rice-eclipse/arca/ARCA/ARCA Block Diagram.pdf

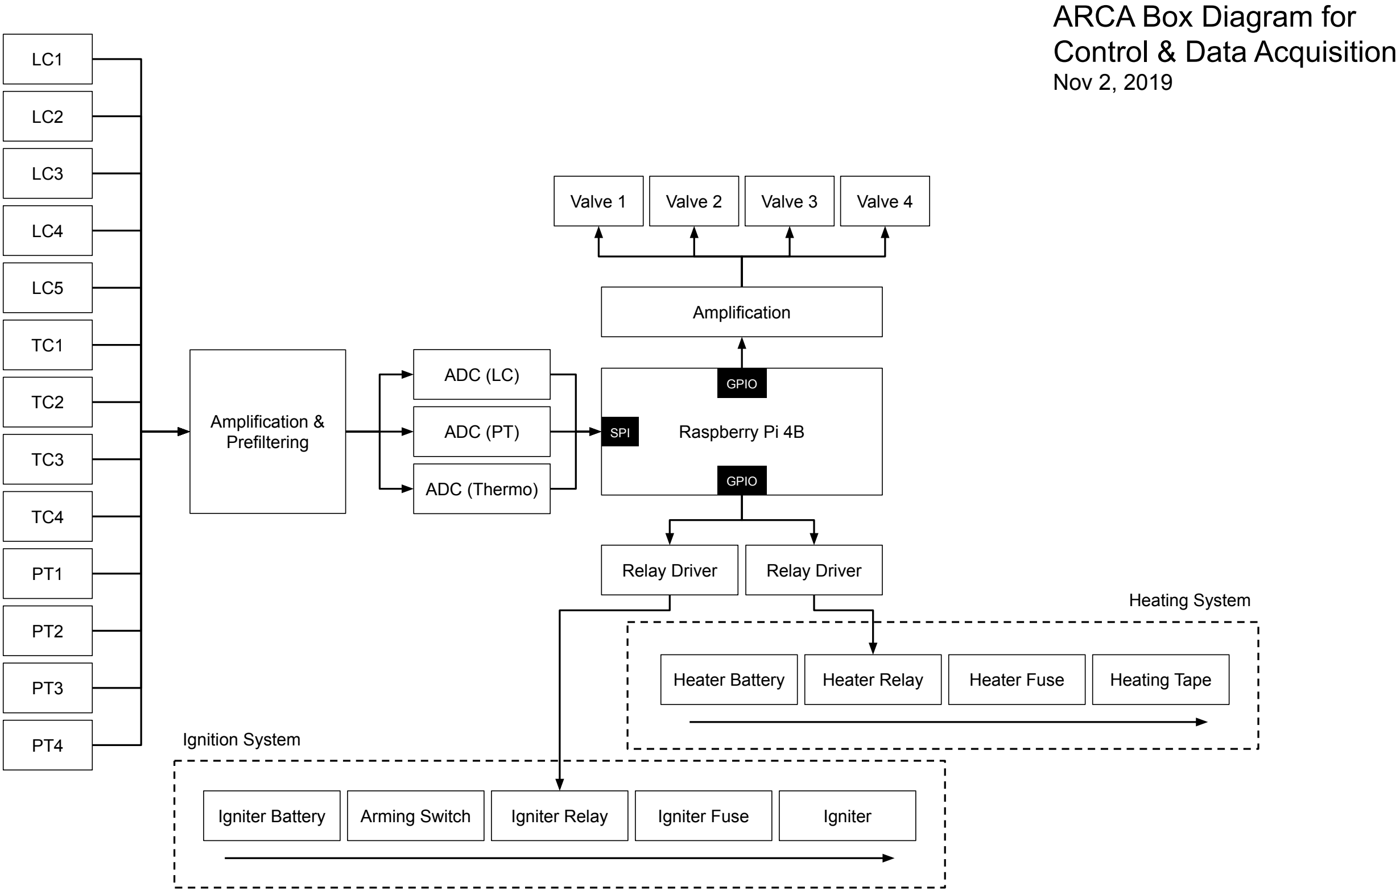
[picture p1: figure]
Raspberry Pi 4B; Amplification; Valve 1; Valve 2; Valve 3; Valve 4; ADC (LC); ADC (PT); ADC (Thermo); Amplification & Prefiltering; Relay Driver; Igniter Battery; Arming Switch; Igniter Relay; Igniter Fuse; Igniter; Heater Battery; Heater Relay; Heater Fuse; Heating Tape; Ignition System; Heating System; SPI; GPIO; ARCA Box Diagram for Control & Data Acquisition; Nov 2, 2019
