rice-eclipse/arca/ARCA/nass_magnet_overview_108_030_0264.PNG

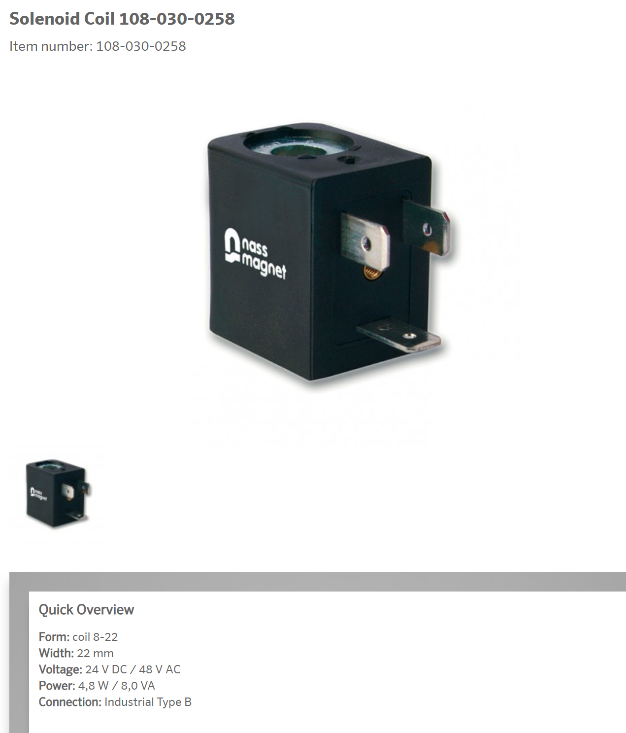
ARCA/nass_magnet_overview_108_030_0264.PNG
