rice-eclipse/arca/arca-2.0/3D CAD/CONNECTOR ANGLED 5MM PITCH (PHOENIX LPTA 2.5-X-5.0)/CONNECTOR ANGLED 5MM PITCH (PHOENIX LPTA 2.5-X-5.0).SLDASM

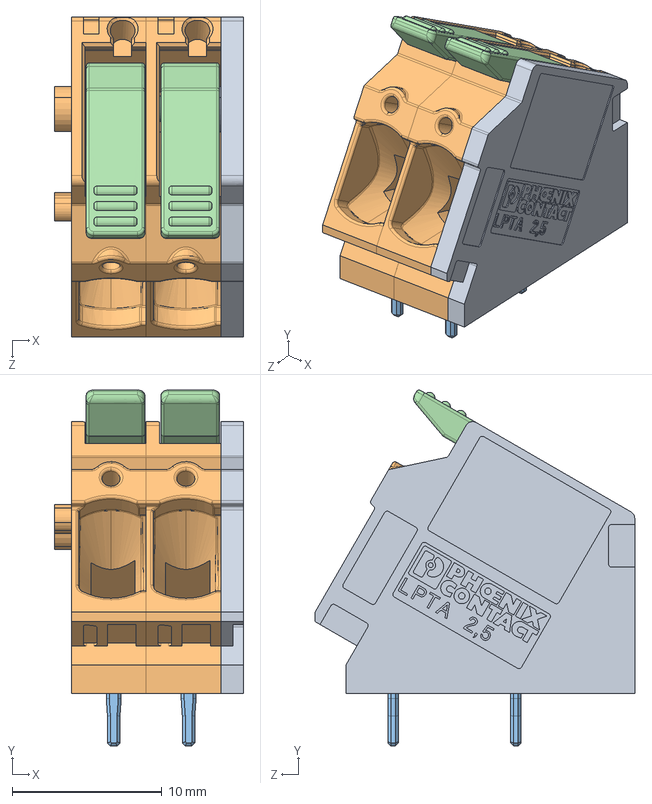
[picture p3: CAD file, 2022-02-19]
arca-2.0/3D CAD/CONNECTOR ANGLED 5MM PITCH (PHOENIX LPTA 2.5-X-5.0)/CONNECTOR ANGLED 5MM PITCH (PHOENIX LPTA 2.5-X-5.0).SLDASM
12.6 x 23.8 x 21.4 mm
DK_LPTA_2_5_5_00
PK_LPTA_2_5_5_00 x 2
LP_LPT_2_5_3_50 x 4
AC_LPT_2_5_LEVER x 2
