rice-eclipse/arca/arca-2.0/3D CAD/EXPORT/BOARD ARCA2.0 EAGLE EXPORT.SLDASM

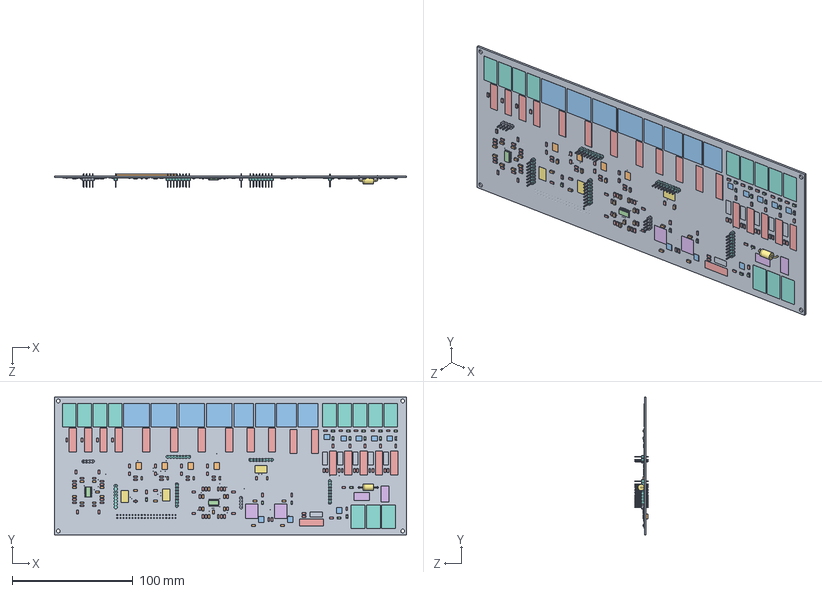
[picture p4: CAD file, 2022-02-19]
arca-2.0/3D CAD/EXPORT/BOARD ARCA2.0 EAGLE EXPORT.SLDASM
292.1 x 114.3 x 11.3 mm
Board^BOARD ARCA2.0 EAGLE EXPORT
0.1u^BOARD ARCA2.0 EAGLE EXPORT x 29
SS54^BOARD ARCA2.0 EAGLE EXPORT x 8
CHIPLED_1206^BOARD ARCA2.0 EAGLE EXPORT x 16
68^BOARD ARCA2.0 EAGLE EXPORT x 85
LM1084-ADJ^BOARD ARCA2.0 EAGLE EXPORT x 2
DO201-15^BOARD ARCA2.0 EAGLE EXPORT
LPTA-2POS^BOARD ARCA2.0 EAGLE EXPORT x 12
FQP30N06L^BOARD ARCA2.0 EAGLE EXPORT x 6
MCP6N11R^BOARD ARCA2.0 EAGLE EXPORT x 4
LPTA-4POS^BOARD ARCA2.0 EAGLE EXPORT x 4
LM324D^BOARD ARCA2.0 EAGLE EXPORT x 2
178.6165^BOARD ARCA2.0 EAGLE EXPORT x 18
1101M2S3CQE2^BOARD ARCA2.0 EAGLE EXPORT x 2
MCP3208SN^BOARD ARCA2.0 EAGLE EXPORT x 3
1X08^BOARD ARCA2.0 EAGLE EXPORT x 5
1X04^BOARD ARCA2.0 EAGLE EXPORT x 2
2540-5^BOARD ARCA2.0 EAGLE EXPORT
LPTA-3POS^BOARD ARCA2.0 EAGLE EXPORT x 4
