rice-eclipse/arca/arca-2.0/3D CAD/BOARD INSERT ASSEMBLY.SLDASM

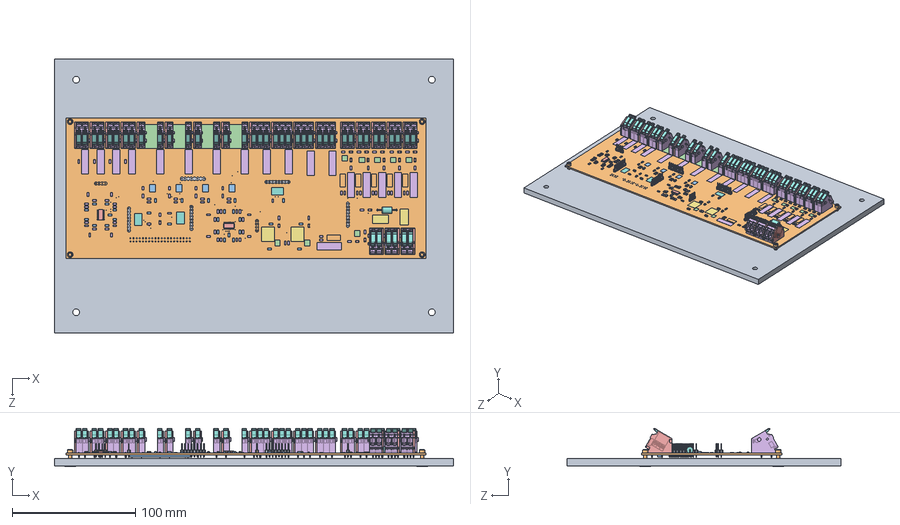
[picture p5: CAD file, 2022-02-19]
arca-2.0/3D CAD/BOARD INSERT ASSEMBLY.SLDASM
323.9 x 31.2 x 222.2 mm
BASE BOARD
Board^BOARD ARCA2.0 EAGLE EXPORT
0.1u^BOARD ARCA2.0 EAGLE EXPORT x 29
SS54^BOARD ARCA2.0 EAGLE EXPORT x 8
CHIPLED_1206^BOARD ARCA2.0 EAGLE EXPORT x 16
68^BOARD ARCA2.0 EAGLE EXPORT x 85
LM1084-ADJ^BOARD ARCA2.0 EAGLE EXPORT x 2
DO201-15^BOARD ARCA2.0 EAGLE EXPORT
LPTA-2POS^BOARD ARCA2.0 EAGLE EXPORT x 12
FQP30N06L^BOARD ARCA2.0 EAGLE EXPORT x 6
MCP6N11R^BOARD ARCA2.0 EAGLE EXPORT x 4
LPTA-4POS^BOARD ARCA2.0 EAGLE EXPORT x 4
LM324D^BOARD ARCA2.0 EAGLE EXPORT x 2
178.6165^BOARD ARCA2.0 EAGLE EXPORT x 18
1101M2S3CQE2^BOARD ARCA2.0 EAGLE EXPORT x 2
MCP3208SN^BOARD ARCA2.0 EAGLE EXPORT x 3
1X08^BOARD ARCA2.0 EAGLE EXPORT x 5
1X04^BOARD ARCA2.0 EAGLE EXPORT x 2
2540-5^BOARD ARCA2.0 EAGLE EXPORT
LPTA-3POS^BOARD ARCA2.0 EAGLE EXPORT x 4
DK_LPTA_2_5_5_00 x 20
PK_LPTA_2_5_5_00 x 44
LP_LPT_2_5_3_50 x 88
AC_LPT_2_5_LEVER x 44
TEE NUT #4-40 (MCMASTER 90975A002) x 4
SHCS STL #4-40 (MCMASTER) x 4
