rice-eclipse/arca/arca-2.0/3D CAD/CONNECTOR ANGLED 5MM PITCH (PHOENIX LPTA 2.5-X-5.0)/AC_LPT_2_5_LEVER.SLDPRT

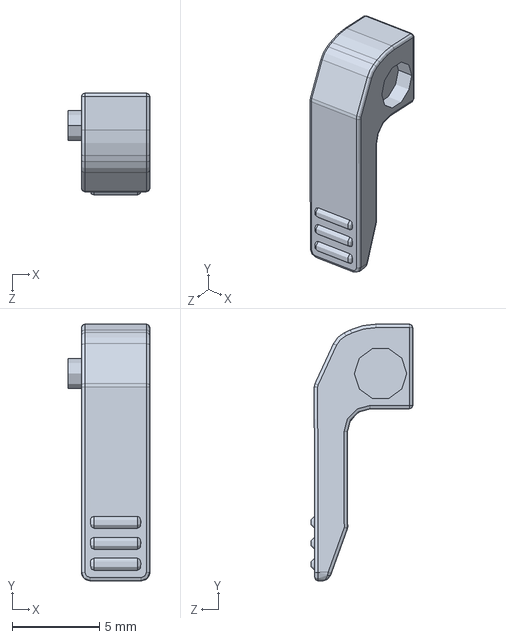
[picture p7: CAD file, 2022-02-19]
arca-2.0/3D CAD/CONNECTOR ANGLED 5MM PITCH (PHOENIX LPTA 2.5-X-5.0)/AC_LPT_2_5_LEVER.SLDPRT
4.68 x 14.7 x 5.83 mm
