rice-eclipse/arca/arca-2.0/3D CAD/CONNECTOR ANGLED 5MM PITCH (PHOENIX LPTA 2.5-X-5.0)/PK_LPTA_2_5_5_00.SLDPRT

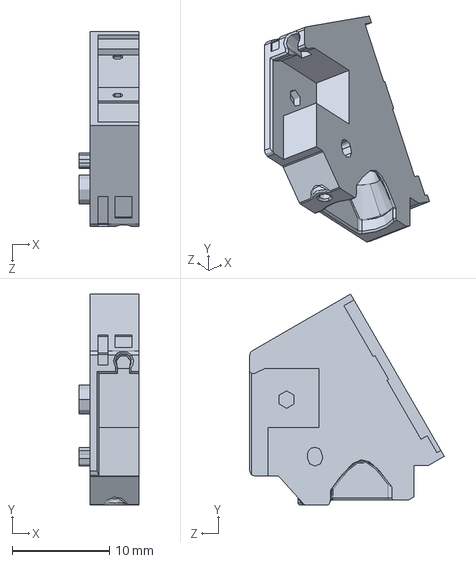
[picture p8: CAD file, 2022-02-19]
arca-2.0/3D CAD/CONNECTOR ANGLED 5MM PITCH (PHOENIX LPTA 2.5-X-5.0)/PK_LPTA_2_5_5_00.SLDPRT
6.13 x 21.7 x 20.0 mm
