rice-eclipse/arca/arca-2.0/3D CAD/BASE BOARD.SLDPRT

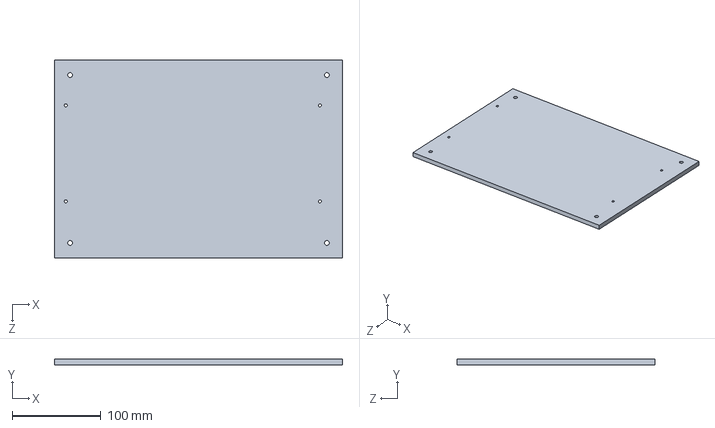
[picture p9: CAD file, 2022-02-19]
arca-2.0/3D CAD/BASE BOARD.SLDPRT
323.9 x 6.35 x 222.2 mm
