rice-eclipse/arca/arca-2.0/3D CAD/TEE NUT #4-40 (MCMASTER 90975A002).SLDPRT

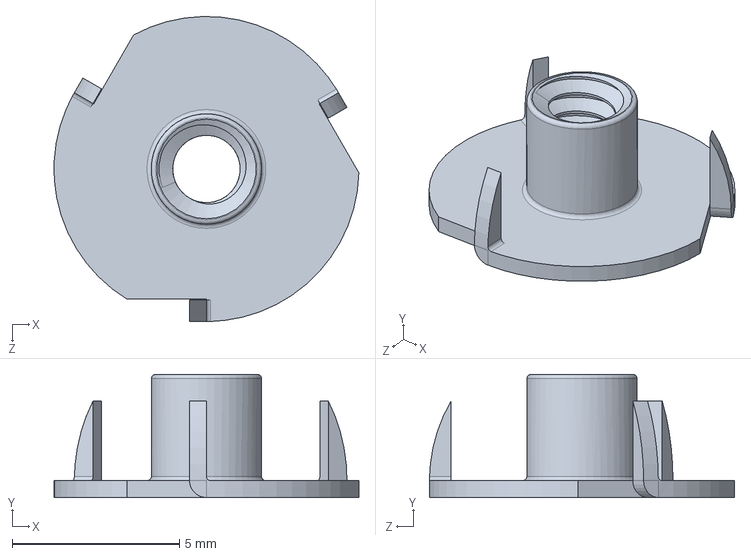
[picture p10: CAD file, 2022-02-19]
arca-2.0/3D CAD/TEE NUT #4-40 (MCMASTER 90975A002).SLDPRT
9.12 x 3.68 x 9.13 mm
