rice-eclipse/arca/arca-2.0/3D CAD/SHCS STL #4-40 (MCMASTER).SLDPRT

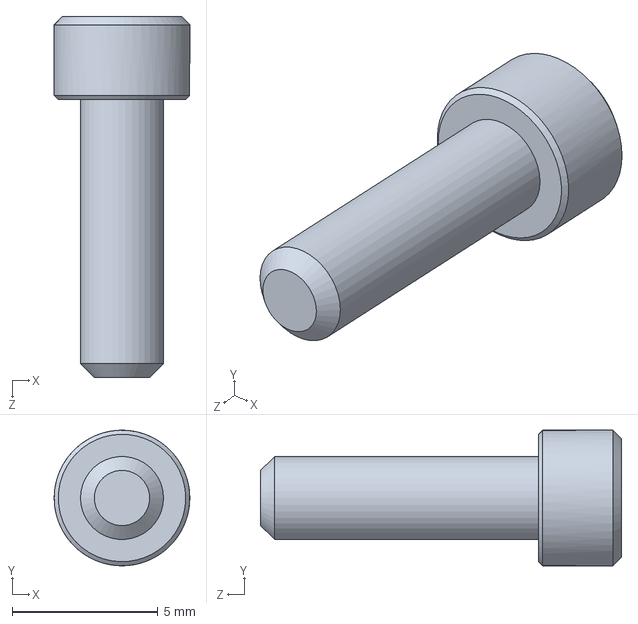
[picture p11: CAD file, 2022-02-19]
arca-2.0/3D CAD/SHCS STL #4-40 (MCMASTER).SLDPRT
4.65 x 4.65 x 12.4 mm
