rice-eclipse/arca/(list of files, cad)

Other CAD files:
eagle arca/arca.DWG
arca-2.0/3D CAD/CONNECTOR ANGLED 5MM PITCH (PHOENIX LPTA 2.5-X-5.0)/DK_LPTA_2_5_5_00.SLDPRT
arca-2.0/3D CAD/CONNECTOR ANGLED 5MM PITCH (PHOENIX LPTA 2.5-X-5.0)/LP_LPT_2_5_3_50.SLDPRT
