rice-eclipse/arca/ARCA/JLC Status/ARCA 1.1 Design Changes.txt

- Replace MCP6N11 inamp footprints to match real size
- Set pullup resistor values on SPI CS for ADCs to 2k
- Re-routed everything
- Rounded resistor values on Butterworth filters to closest E48 values
