rice-eclipse/arca/ARCA/Issues with board.docx

Fix these in a reprint run down the line.

- No silkscreen for SPI debug pins.
- LC circuit is wrong, need to use instrumentation amplifier for good performance.
- PT powered off of unregulated 12V supply. Need to use 10V or else we’re fucked.
- Burned out 5V LED, use bigger resistor next time.
- Should also take some time to make an ignition measurement device.
