rice-eclipse/arca/ARCA/arca.pdf

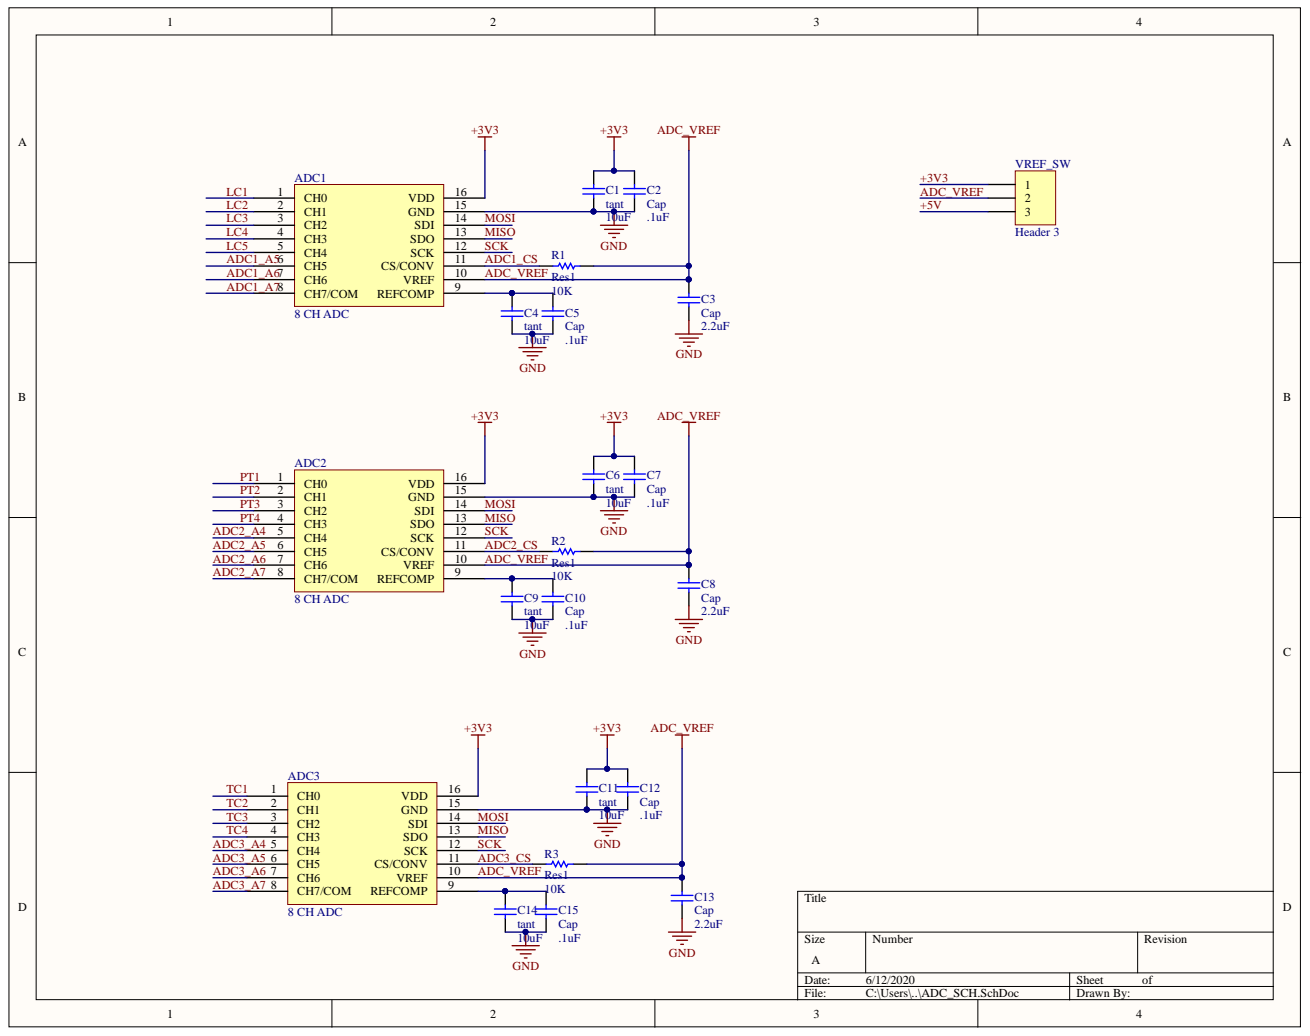
[picture p12: page 1]

A DC_VRE F

A DC_VRE F Re s 1

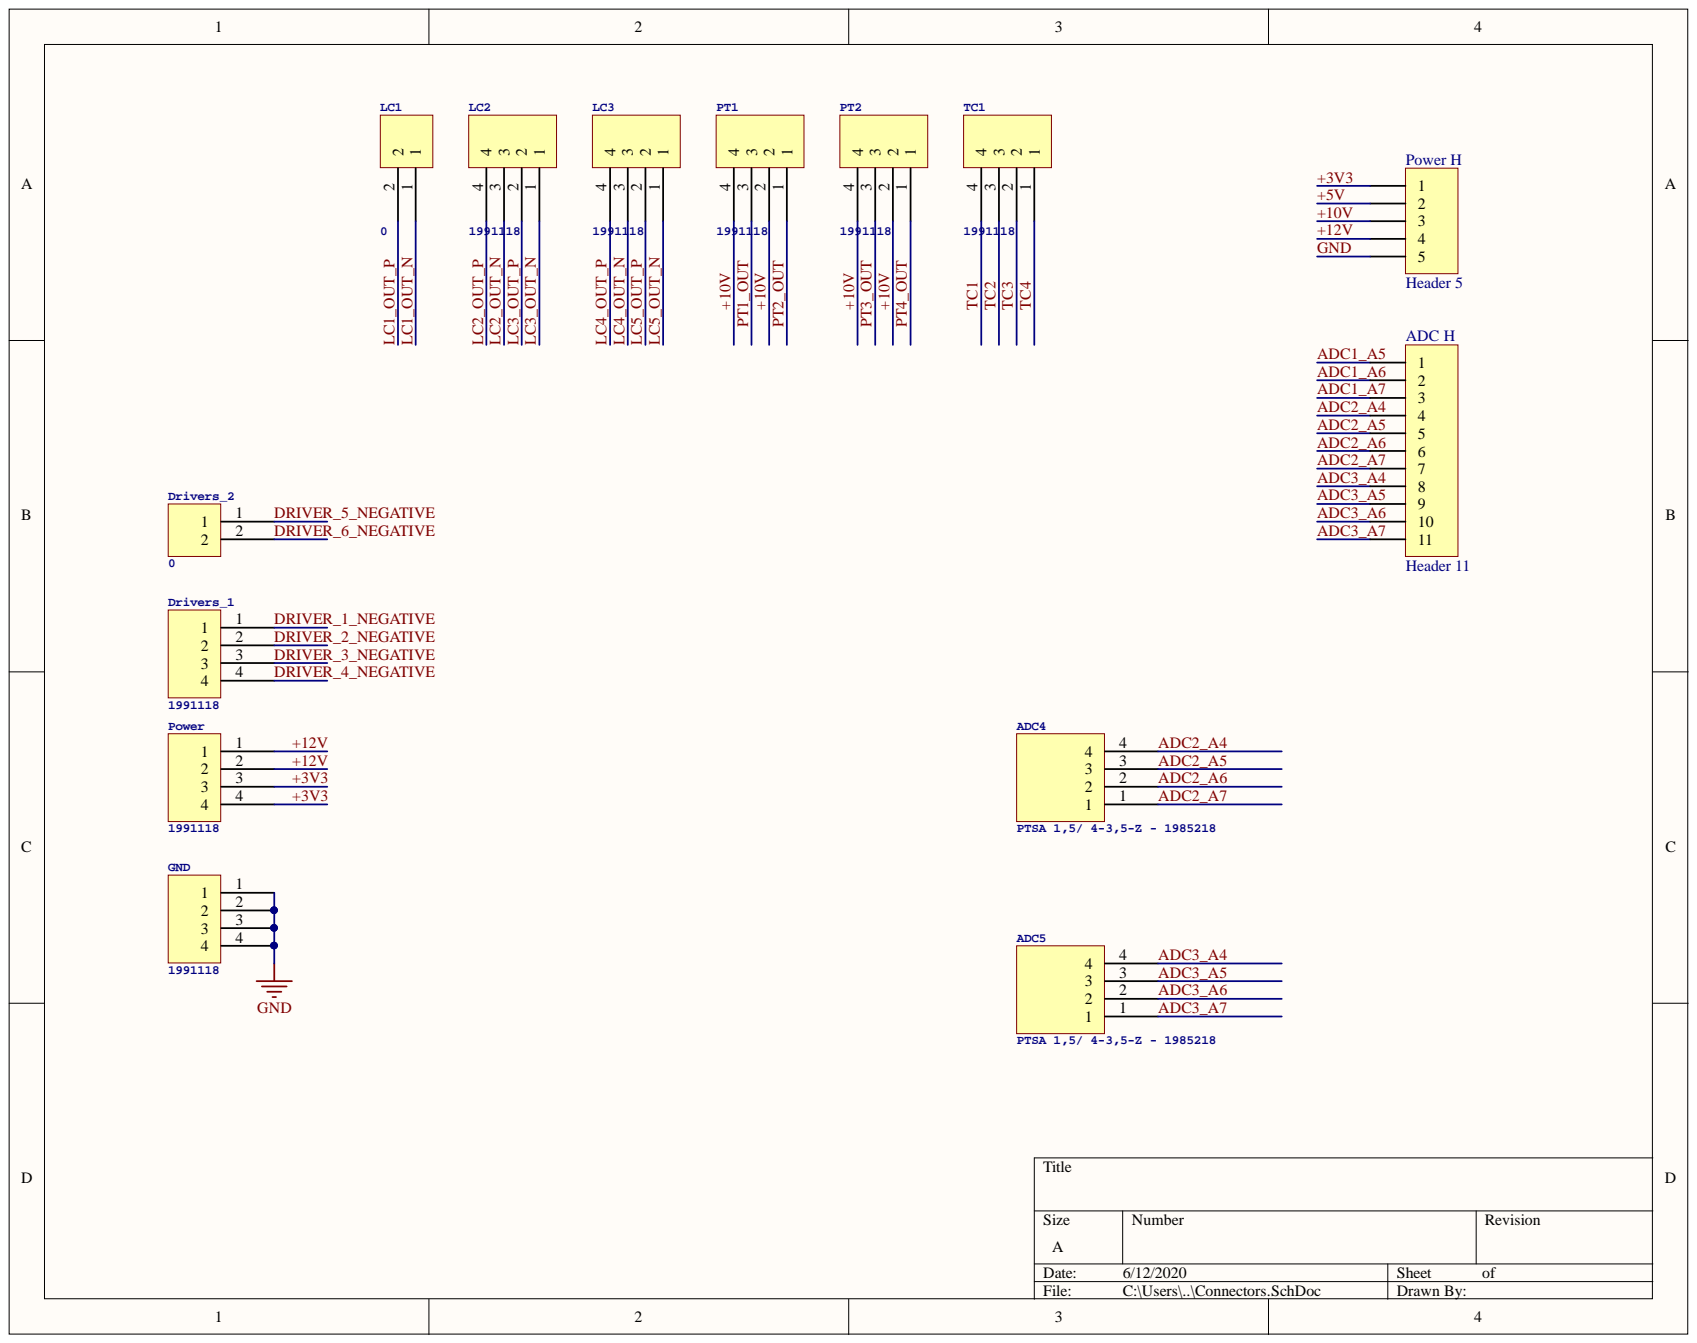
[picture p13: page 2]

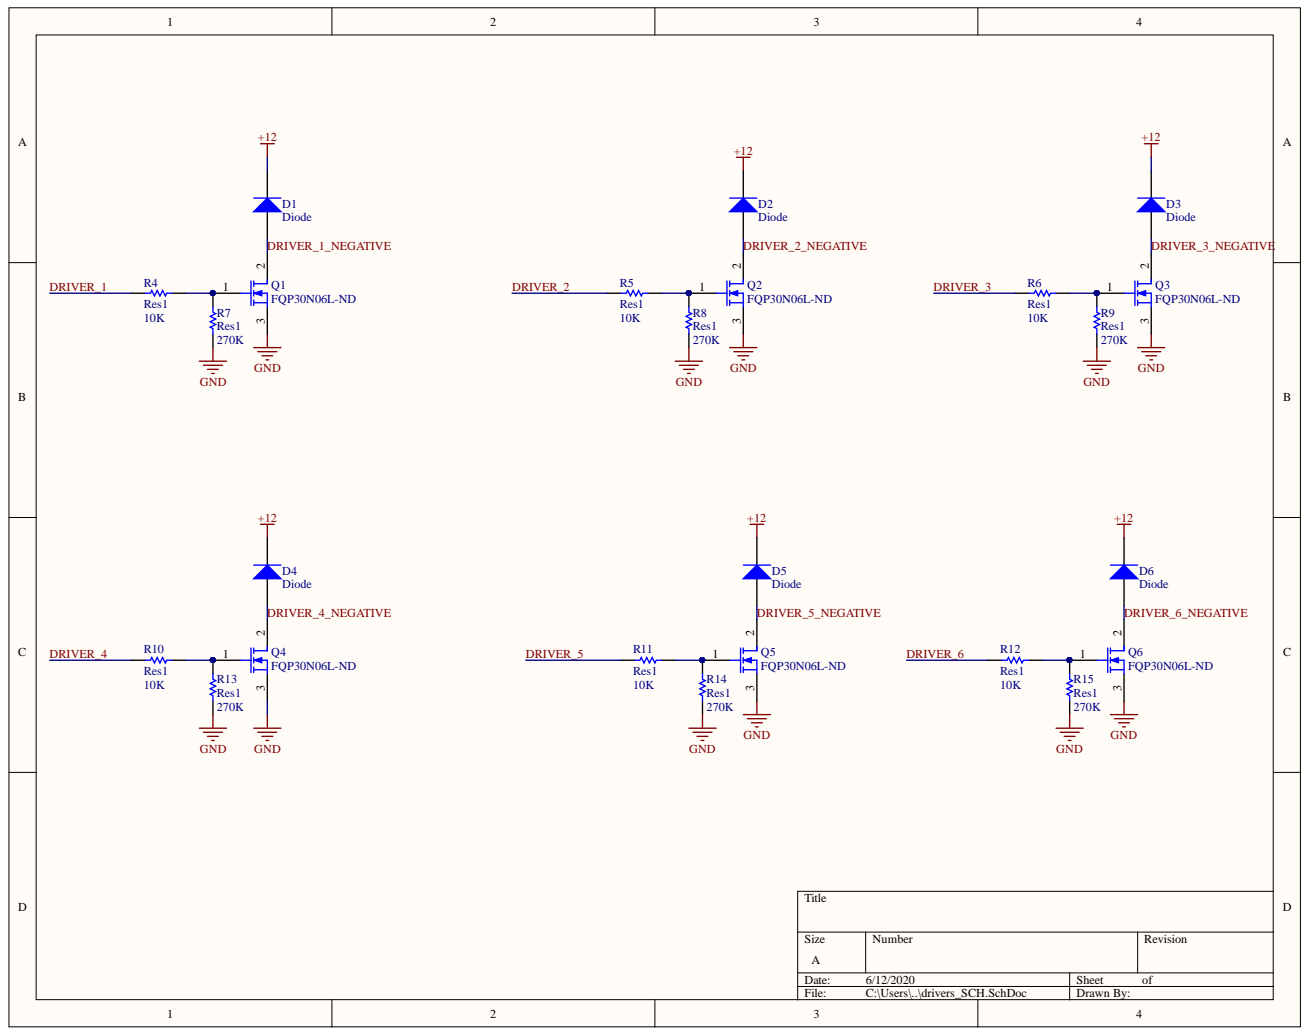
[picture p14: page 3]

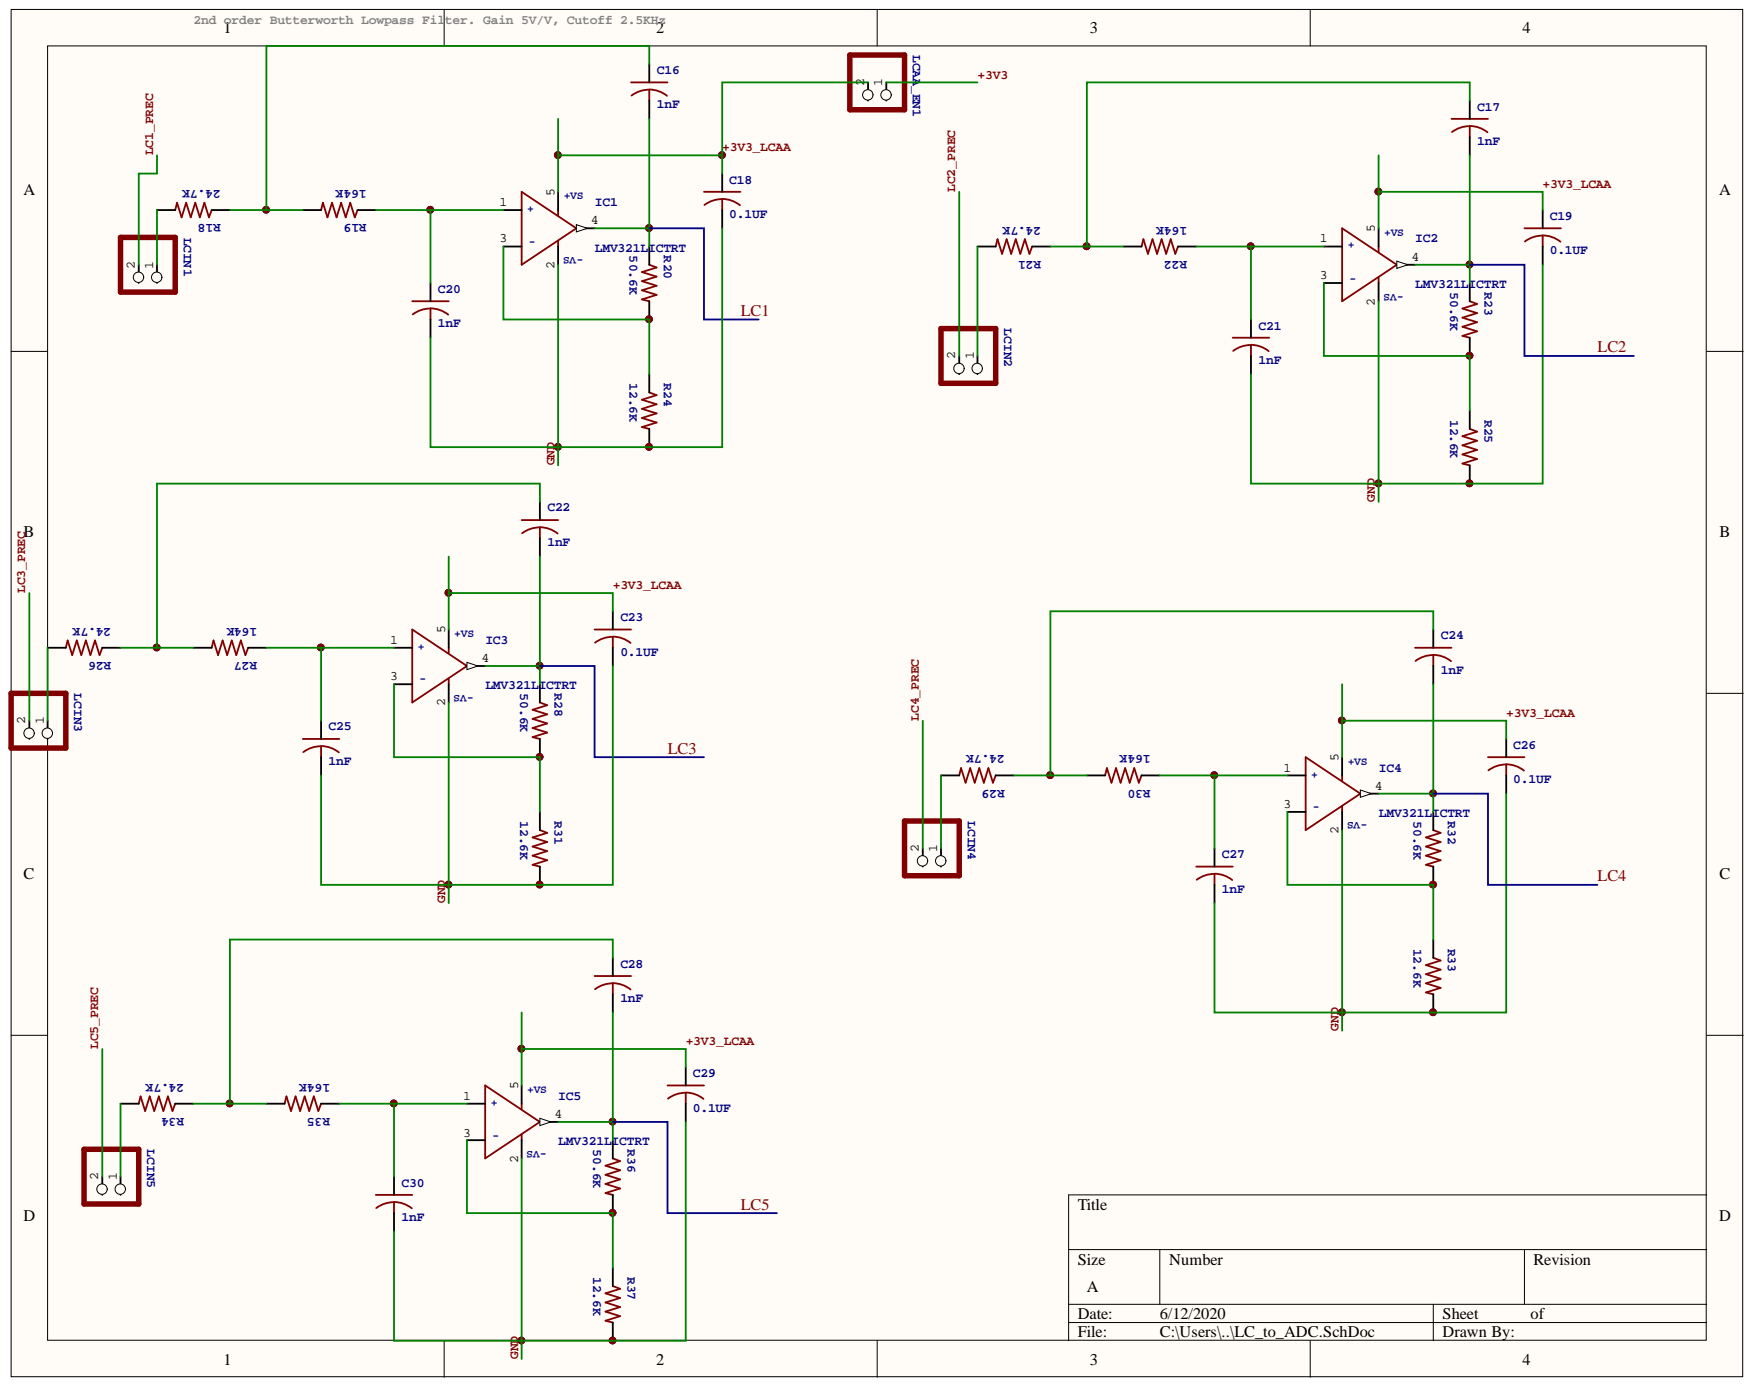
[picture p15: page 4]

2nd order Butterworth Lowpass Filter. Gain 5V/V, Cutoff 2.5KHz

LMV321LICTRT

+3V3_LCAA 5_PREC

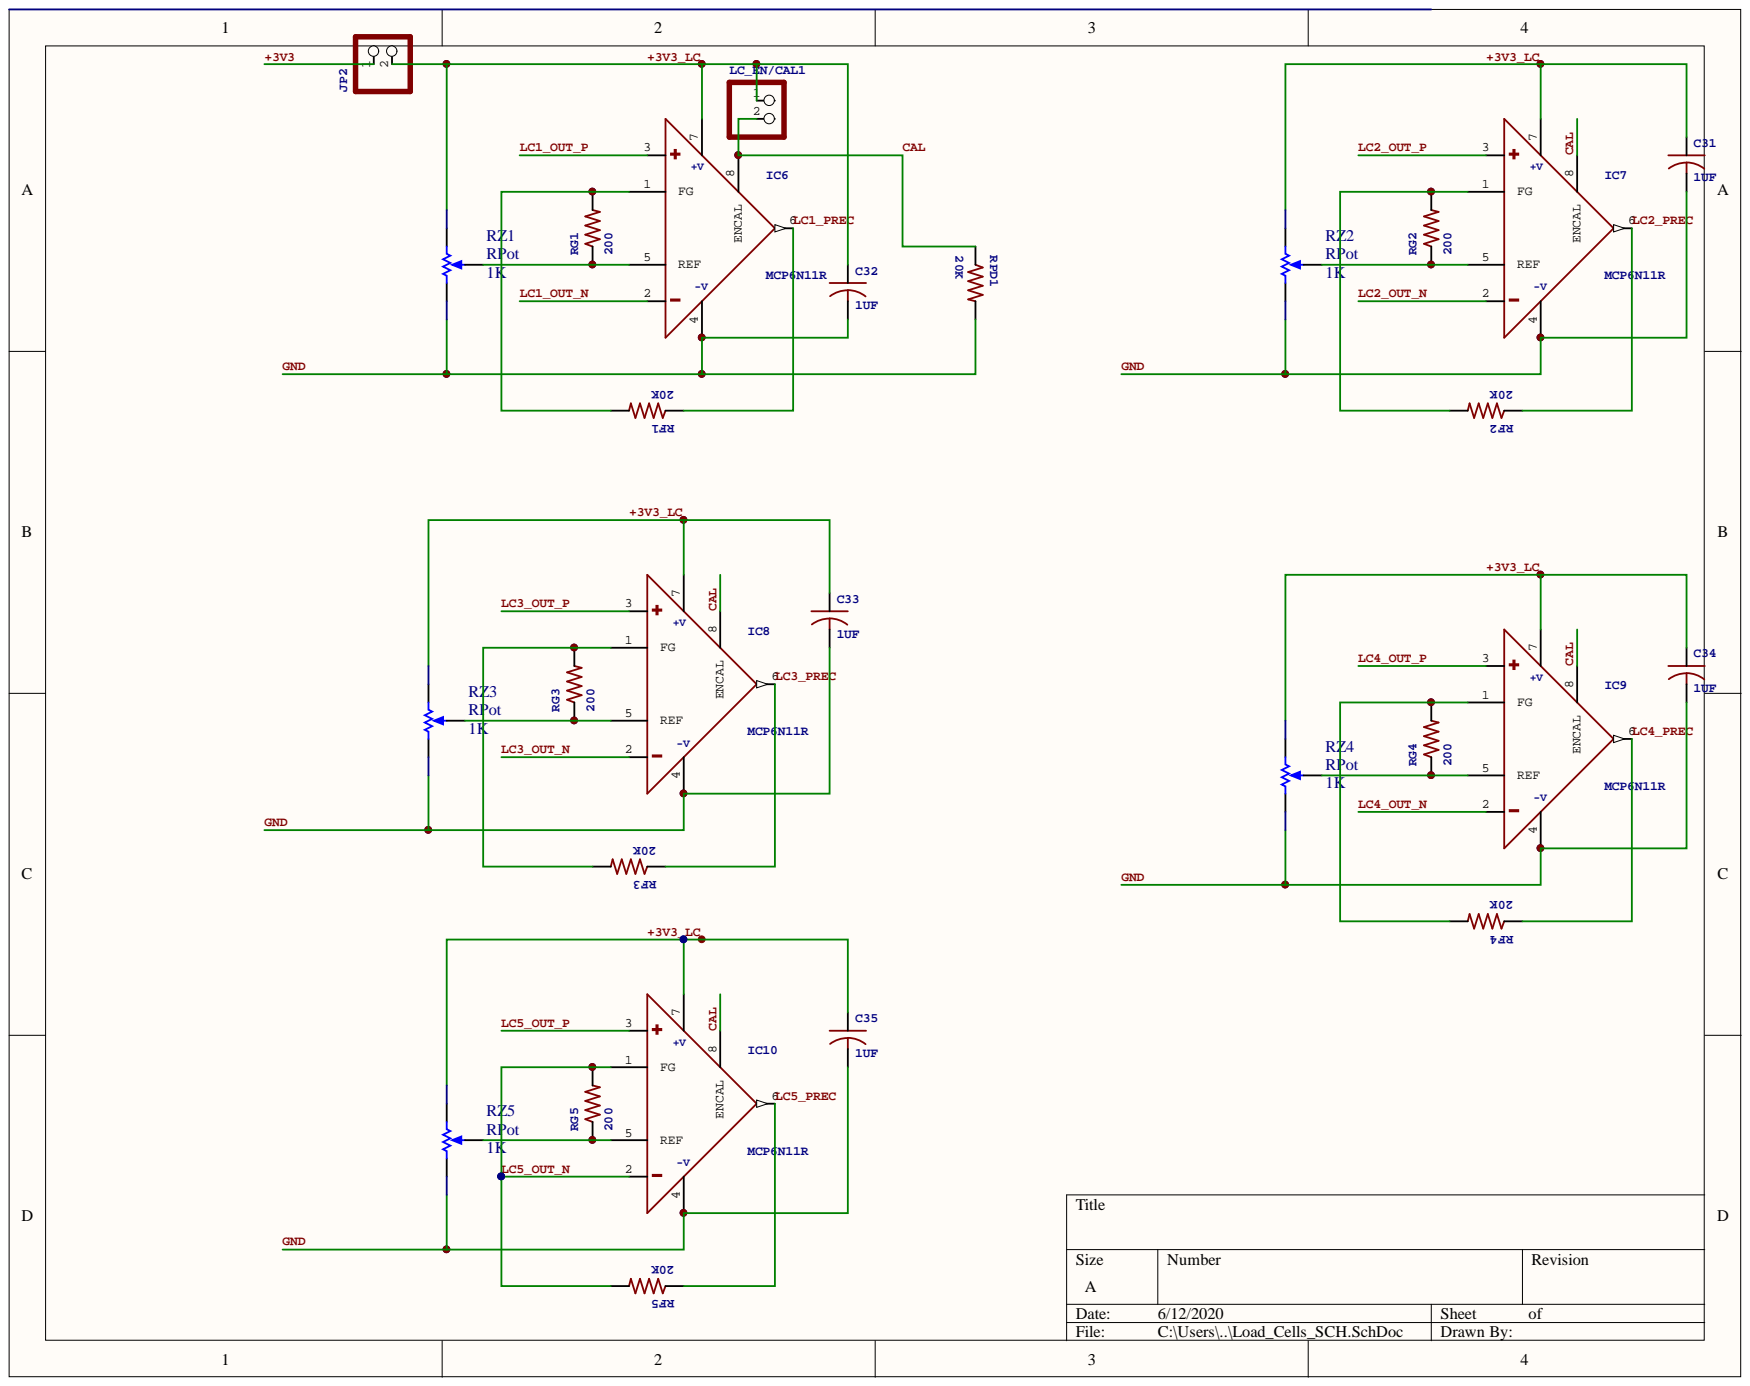
[picture p16: page 5]

LC_EN/CAL1

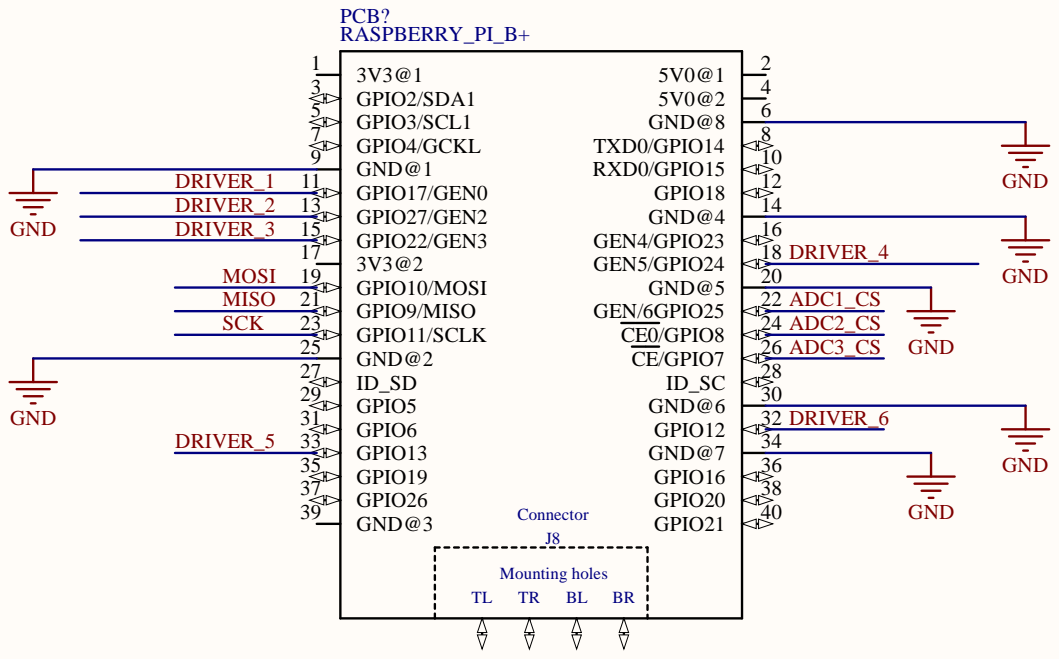
[picture p17: page 6]

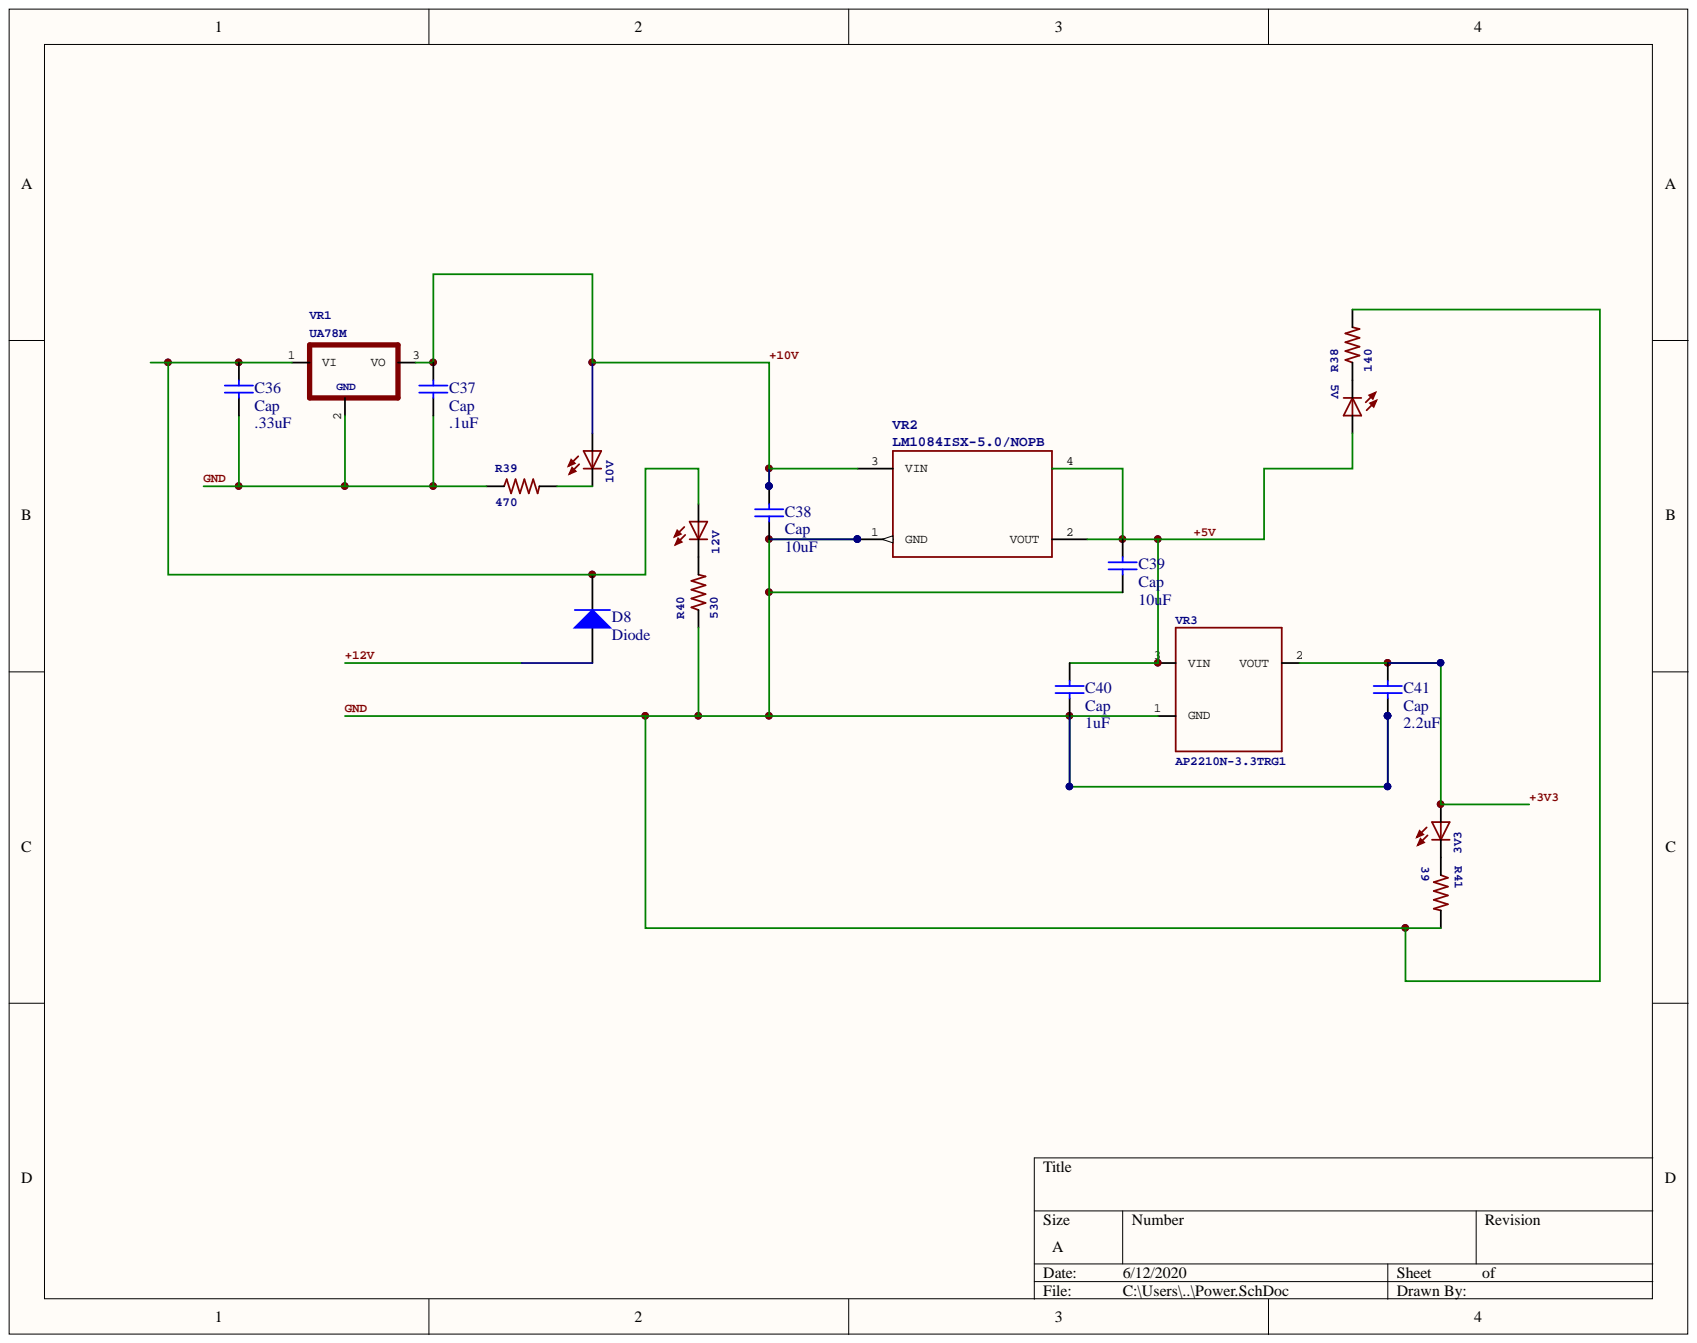
[picture p18: page 7]

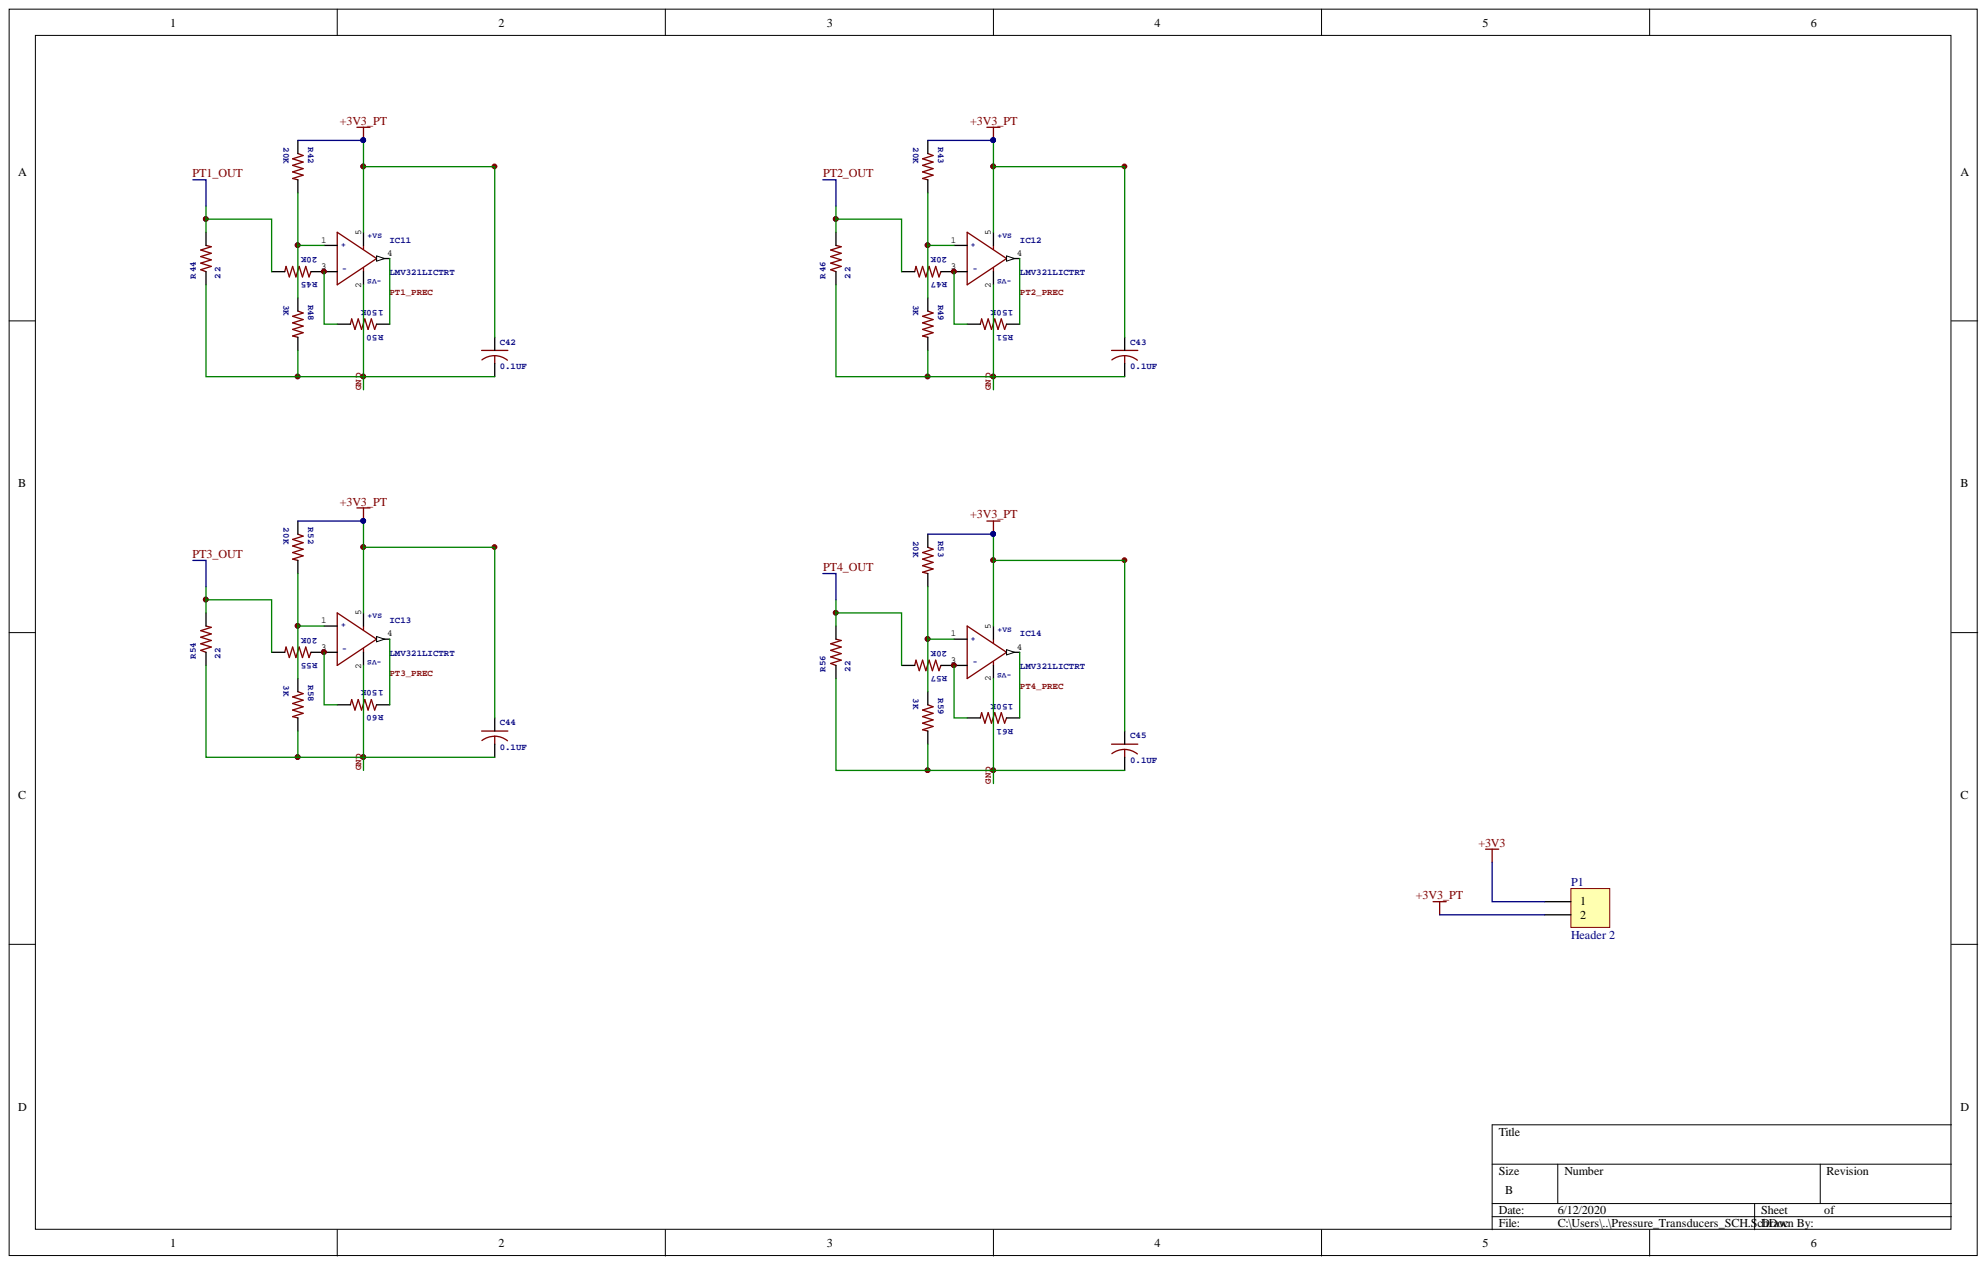
[picture p19: page 8]

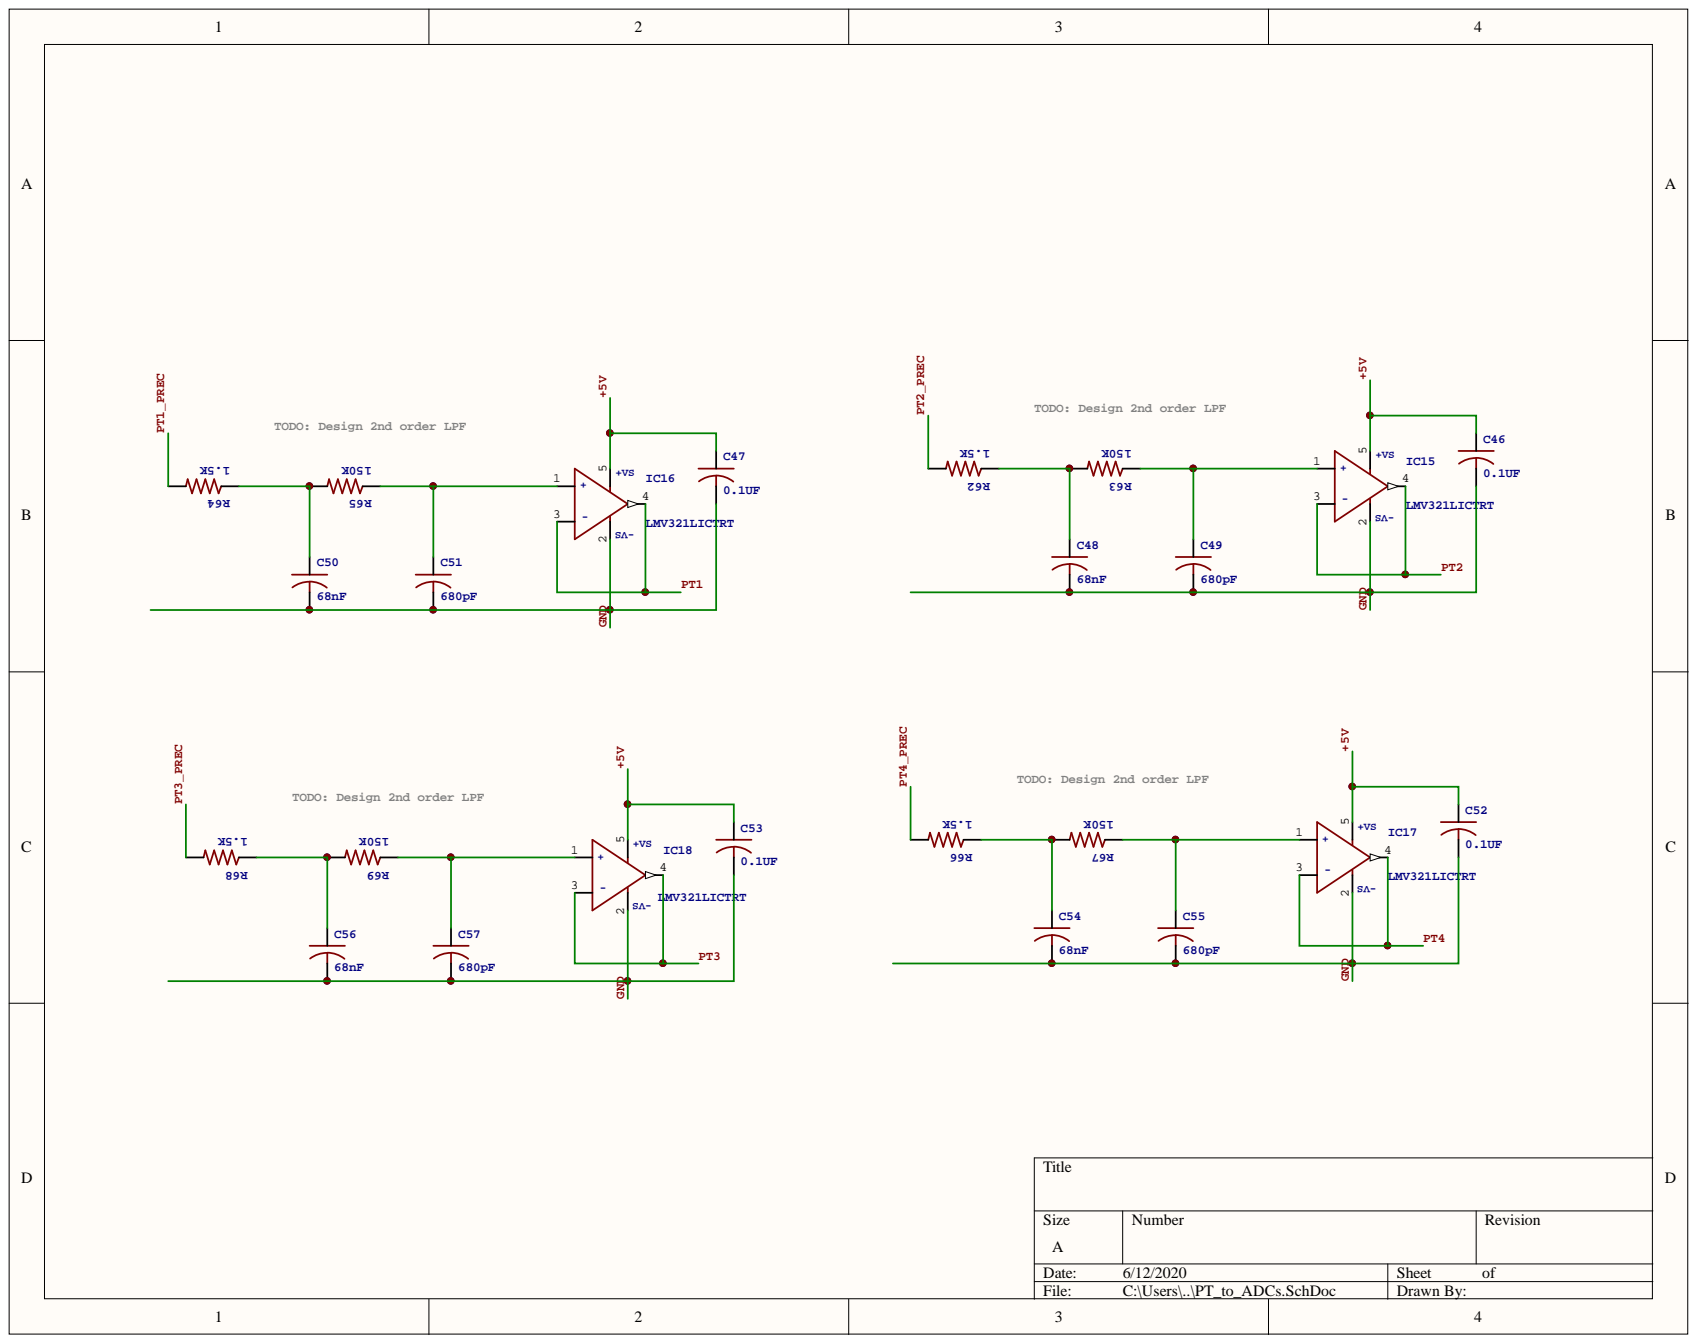
[picture p20: page 9]

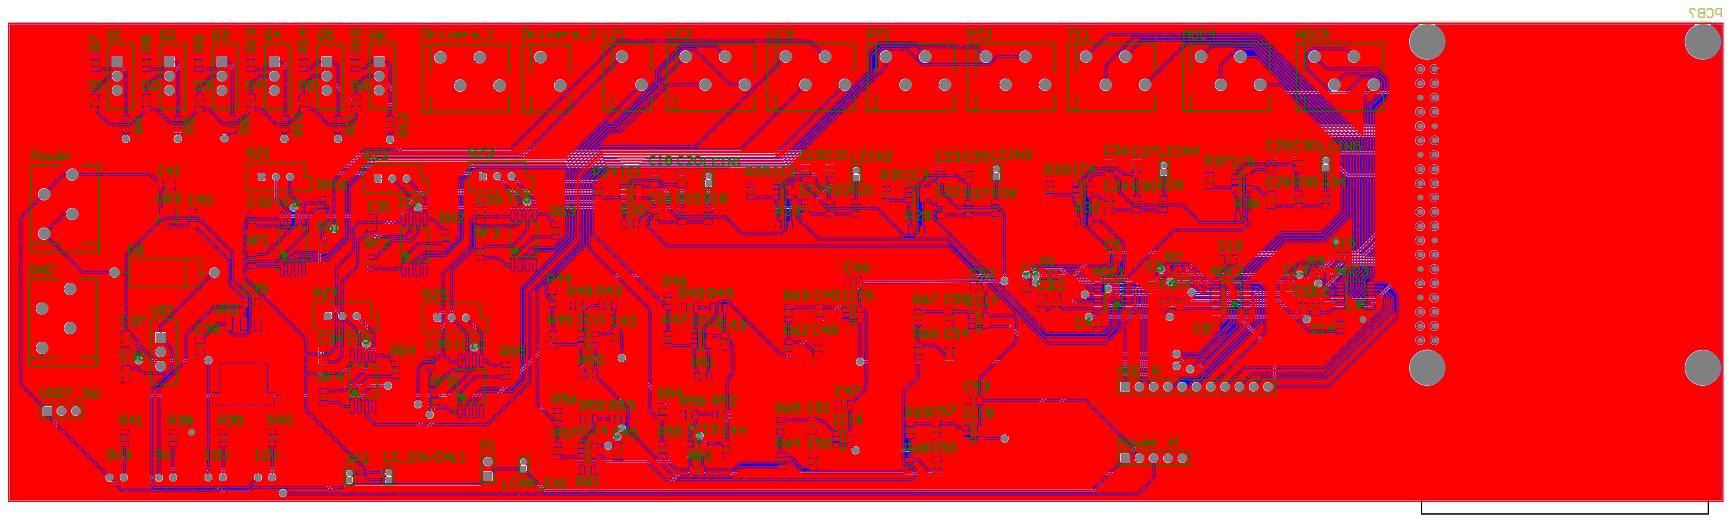
[picture p21: page 10]

LED5MM | CHIPLEDLG R971, LG N971, LY N971, LG Q971, LY Q971, LO R971, LY R971 LH N974, LH R974LS Q976, LO Q976, LY Q976LO Q996- Hyper CHIPLEDLW Q18SLB Q993, LB Q99A, LB R99A-SideLEDLS A670, LO A670, LY A670, LG A670, LP A670LB A673, LV A673, LT A673, LW A673LH A674LY A675LS A676, LA | 3V3, 5V, 10V, 12V | LED5MM | LED5MM | | 4

Comment | LEDOSRAM:-Description | Designator | Footprint | LibRef | Quantity

Header 11 | Header, 11-Pin | ADC H | HDR1X11 | Header 11 | | 1

8 CH ADC | Analog to Digital Converters -ADC 16-bit, 8-ch. Serial, Micropower ADC | ADC1, ADC2, ADC3 | SOP64P600X 175-16N | LTC1867 | | 3

PTSA 1,5/ 4-3,5-Z -1985218 | Phoenix Contact PCB Terminal Spring Cage Clamp + Button 4 pos | ADC4, ADC5 | 4PinCanCon nector | PTSA 1,5/ 4-3,5-Z -1985218 | | 2

tant | Capacitor | C1, C4, C6, C9, C11 | CAPCP2012 X06N | Cap | | 5

Cap | Capacitor | C2, C3, C5, C7, C8, C10, C12, C13, C15, C36, C37, C38, C39, C40, C41 | CAPCP2012 X06N | Cap | 15

tant | Capacitor | C14 | RESC_0805_ 2012 | Cap | | 1

1nF | CAPACITOR, American symbol | C16, C17, C20, C21, C22, C24, C25, C27, C28, C30 | CAPCP2012 X06N | C-USC0805 | 10

0.1UF | CAPACITOR, American symbol | C18, C19, C23, C26, C29, C42, C43, C44, C45, C46, C47, C52, C53 | CAPCP2012 X06N | C-USC0805 | 13

1UF | CAPACITOR, American symbol | C31, C32, C33, C34, C35 | CAPCP2012 X06N | C-USC0805 | | 5

68nF | CAPACITOR, American symbol | C48, C50, C54, C56 | CAPCP2012 X06N | C-USC0805 | | 4

680pF | CAPACITOR, American symbol | C49, C51, C55, C57 | CAPCP2012 X06N | C-USC0805 | | 4

Diode | Default Diode | D1, D2, D3, D4, D5, D6 | DIOC2012X0 6N | Diode | | 6

Diode | Default Diode | D8 | DIODE-0.7 | Diode | | 1

1991118 | | Drivers_1, GND, LC2, LC3, Power, PT1, PT2, TC1 | 4PinCanCon nector | 1991118 | | 8

0 | Phoenix Contact Connector PCB Terminal 2 port | Drivers_2, LC1 | 2pos_green_ boi | 1991095 | | 2

LMV321LICT RT | High Performance , 145 MHz FastFET Op AmpsSource : http://www.analog.com/static/import ed-files/data_sh eets/AD8065 _8066.pdf | IC1, IC2, IC3, IC4, IC5, IC11, IC12, IC13, IC14, IC15, IC16, IC17, IC18 | SOT95P245X 110-5N | LMV321LICT RT | 13

MCP6N11R | Low Cost, Low Power, Instrumentat ion AmplifierSou rce: http://www.analog.com/UploadedFiles/Data_Sheets/3779333 0023930AD6 20_e.pdf | IC6, IC7, IC8, IC9, IC10 | SOIC127P10 30X265-8N | MCP6N11R | | 5

PINHD-1X2 | PIN HEADER | JP2, LC_EN/CAL1 , LCAA_EN1, LCIN1, LCIN2, LCIN3, LCIN4, LCIN5 | MHDR1X2 | PINHD-1X2 | | 8

Header 2 | Header, 2-Pin | P1 | HDR1X2 | Header 2 | | 1

RASPBERRY _PI_B+ | Single Board Computer; 700Mhz; 512Mb RAM; 85.6x53.98x1 7mm; Raspberry Pi B+ Series | PCB? | *RASPBERR Y_PI_B+_RA SPBERRY_PI _B+(Primary) | RASPBERRY _PI_B+ | | 1

Header 5 | Header, 5-Pin | Power H | HDR1X5 | Header 5 | | 1

FQP30N06L-ND | N-Channel MOSFET | Q1, Q2, Q3, Q4, Q5, Q6 | UA78M | MOSFET-N | | 6

Res1 | Resistor | R1, R2, R3, R4, R5, R6, R7, R8, R9, R10, R11, R12, R13, R14, R15 | RESC_0805_ 2012 | Res1 | 15

24.7K | RESISTOR, American symbol | R18, R21, R26, R29, R34 | RESC_0805_ 2012 | R-US_R0805 | | 5

164K | RESISTOR, American symbol | R19, R22, R27, R30, R35 | RESC_0805_ 2012 | R-US_R0805 | | 5

50.6K | RESISTOR, American symbol | R20, R23, R28, R32, R36 | RESC_0805_ 2012 | R-US_R0805 | | 5

12.6K | RESISTOR, American symbol | R24, R25, R31, R33, R37 | RESC_0805_ 2012 | R-US_R0805 | | 5

140 | RESISTOR, American symbol | R38 | RESC_0805_ 2012 | R-US_R0805 | | 1

470 | RESISTOR, American symbol | R39 | RESC_0805_ 2012 | R-US_R0805 | | 1

530 | RESISTOR, American symbol | R40 | RESC_0805_ 2012 | R-US_R0805 | | 1

39 | RESISTOR, American symbol | R41 | RESC_0805_ 2012 | R-US_R0805 | | 1

20K | RESISTOR, American symbol | R42, R43, R45, R47, R52, R53, R55, R57, RF1, RF2, RF3, RF4, RF5, RPD1 | RESC_0805_ 2012 | R-US_R0805 | 14

22 | RESISTOR, American symbol | R44, R46, R54, R56 | RESC_0805_ 2012 | R-US_R0805 | | 4

3K | RESISTOR, American symbol | R48, R49, R58, R59 | RESC_0805_ 2012 | R-US_R0805 | | 4

150K | RESISTOR, American symbol | R50, R51, R60, R61, R63, R65, R67, R69 | RESC_0805_ 2012 | R-US_R0805 | | 8

1.5K | RESISTOR, American symbol | R62, R64, R66, R68 | RESC_0805_ 2012 | R-US_R0805 | | 4

200 | RESISTOR, American symbol | RG1, RG2, RG3, RG4, RG5 | RESC_0805_ 2012 | R-US_R0805 | | 5

RPot | Potentiomet er | RZ1, RZ2, RZ3, RZ4, RZ5 | VR5 | RPot | | 5

UA78M | POSITIVE-VOLTAGE REGULATOR S Source: http://focus.ti.com/lit/ds/symlink/ua7 8m33.pdf | VR1 | UA78M | UA78M* | | 1

LM1084ISX-5.0/NOPB | | VR2 | LM1084ISX-5.0/NOPB | LM1084ISX-5.0/NOPB | | 1

AP2210N-3.3TRG1 | 3.3V regulator300 mA rating. | VR3 | SOT95P245X 110-3N | AP2210N-3.3TRG1 | | 1

Header 3 | Header, 3-Pin | VREF_SW | HDR1X3 | Header 3 | | 1
