rice-eclipse/arca/ARCA/Mk11AvionicsBlockDiagram.pdf

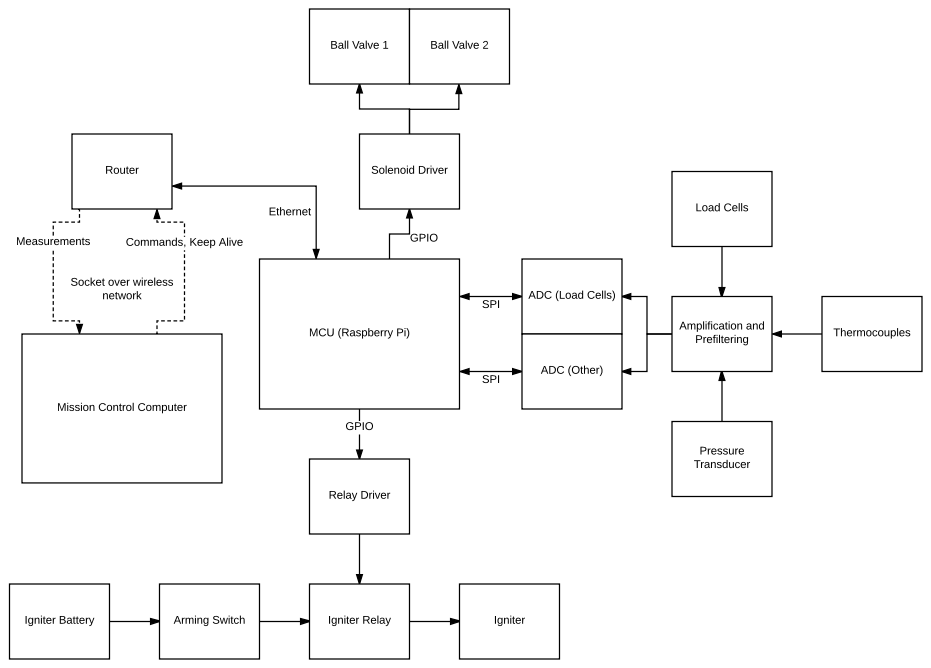
[picture p22: page 1]
SPI; Amplification and Prefiltering; Load Cells; Pressure Transducer; Thermocouples; Solenoid Driver; GPIO; Ball Valve 1; Ball Valve 2; Igniter Relay; Relay Driver; Igniter Battery; Arming Switch; Igniter; Router; Ethernet; Measurements; Commands, Keep Alive

Socket over wireless
network

ADC (Load Cells)

MCU (Raspberry Pi)

ADC (Other) SPI

Mission Control Computer
