rice-eclipse/arca/arca-2.0/arca-2.0-box.pdf

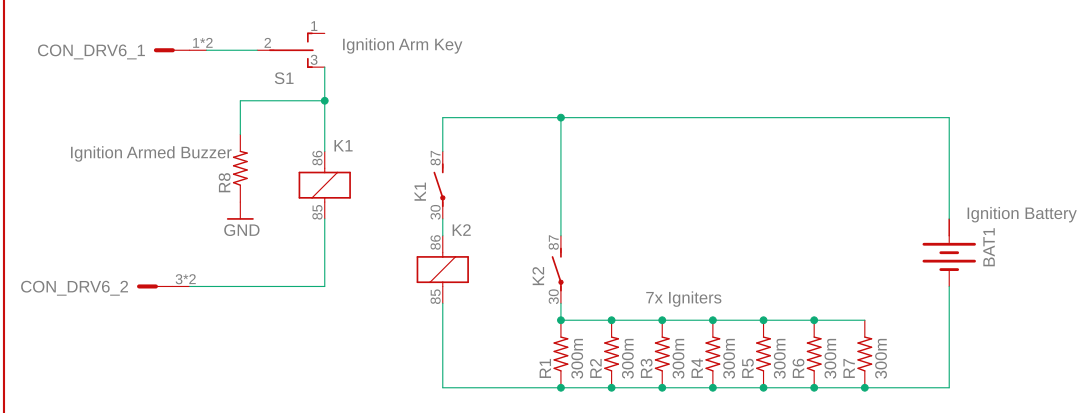
[picture p23: page 1]
