rice-eclipse/arca/(list of files, drawings)

Other design files:
ARCA/1101M2S3CQE2/Imported 1101M2S3CQE2.lia/1101M2S3CQE2.PcbLib
ARCA/1101M2S3CQE2/Imported 1101M2S3CQE2.lia/1101M2S3CQE2.SchLib
ARCA/ADC_Breakout.SchDoc
ARCA/ADC_SCH.SchDoc
ARCA/arca.PcbDoc
ARCA/arca.PrjPCB
ARCA/ARCA_BOX_SCH.SchDoc
ARCA/ARCA_INNERBOX.SchDoc
ARCA/arca_PCAD_2021-03-29.PCB
ARCA/arca_PCAD_2021-04-03.PCB
ARCA/ARCA_SCHLIB.SchLib
ARCA/ARCAPCBLIB.PcbLib
ARCA/Connectors.SchDoc
ARCA/drivers_SCH.SchDoc
ARCA/Heating_Tape.SchDoc
ARCA/Ignitors_SCH.SchDoc
ARCA/IRF640/Imported IRF640.lia/IRF640.PcbLib
ARCA/IRF640/Imported IRF640.lia/IRF640.SchLib
ARCA/LC_to_ADC.SchDoc
ARCA/Load_Cells_SCH.SchDoc
ARCA/Miscellaneous Devices1/Miscellaneous Devices.PcbLib
ARCA/Miscellaneous Devices1/Miscellaneous Devices.SchLib
ARCA/Miscellaneous Devices/Miscellaneous Devices.PcbLib
ARCA/Miscellaneous Devices/Miscellaneous Devices.SchLib
ARCA/Outputs_SCH.SchDoc
ARCA/PI_SCH.SchDoc
ARCA/Power.SchDoc
ARCA/Pressure_Transducers_SCH.SchDoc
ARCA/PT_to_ADCs.SchDoc
ARCA/RASPBERRY_PI_B_/Imported RASPBERRY_PI_B_.lia/RASPBERRY_PI_B_.PcbLib
ARCA/RASPBERRY_PI_B_/Imported RASPBERRY_PI_B_.lia/RASPBERRY_PI_B_.SchLib
ARCA/RASPBERRY_PI_B_/Imported RASPBERRY_PI_B_.lia/Valve_SCH.SchDoc
ARCA/Solenoids_SCH.SchDoc
ARCA/TO254P1054X470X1955-3/Imported TO254P1054X470X1955-3.lia/TO254P1054X470X1955-3.PcbLib
ARCA/TO254P1435X464-4N/Imported TO254P1435X464-4N.lia/TO254P1435X464-4N.PcbLib
ARCA/Top_Level_SCH.SchDoc
