rice-eclipse/arca/arca-2.0/arca-2.0.brd

## EAGLE design arca-2.0/arca-2.0.brd (2022-03-20)

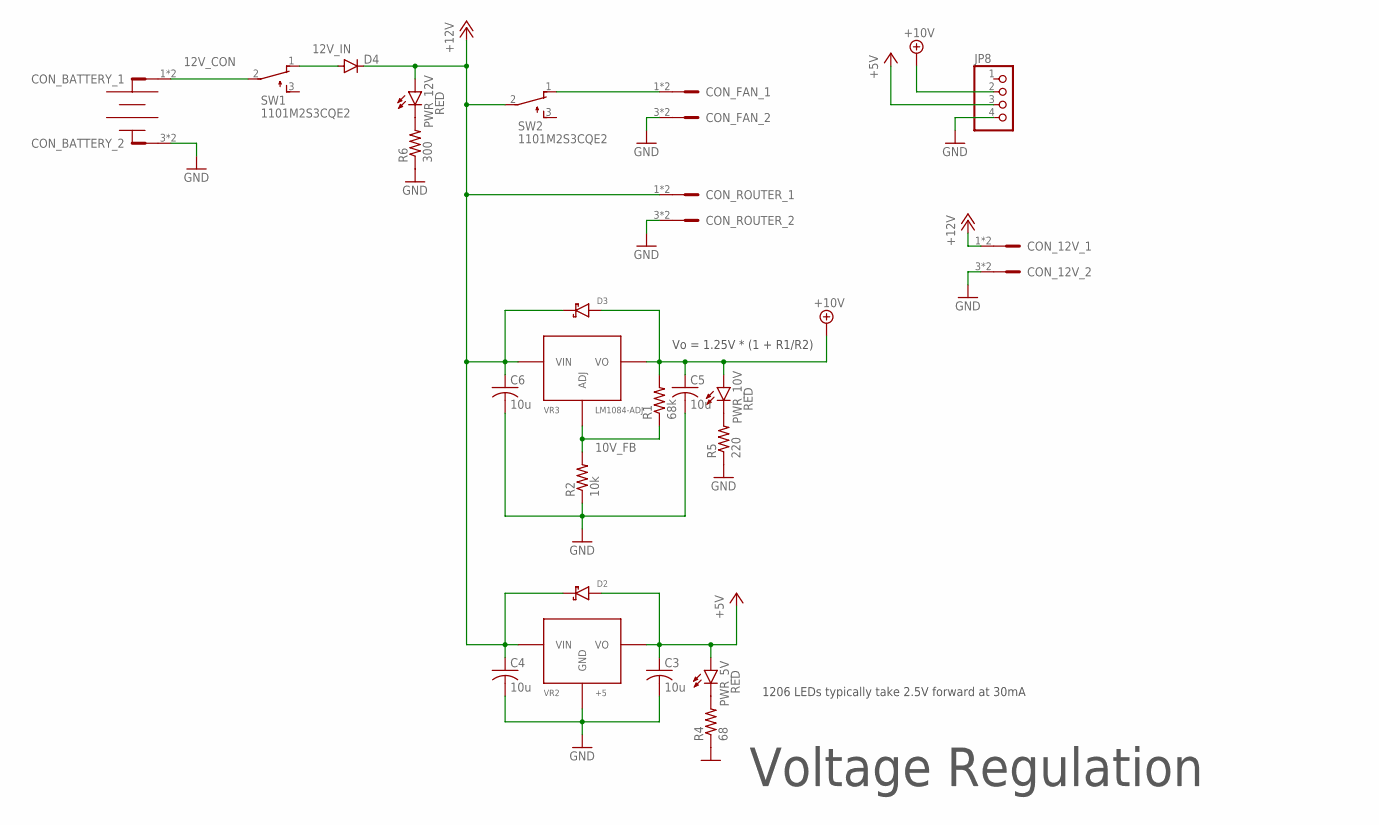
[picture p24: schematic arca-2.0.sch, sheet 1, Power]

Parts:
C3, C4, C5, C6: 10u; C1206
CON_12V: LPTA-2POS; 8.2X2
CON_BATTERY: LPTA-2POS; 8.2X2
CON_FAN: LPTA-2POS; 8.2X2
CON_ROUTER: LPTA-2POS; 8.2X2
D2, D3: SS54; SS*
D4: DIODE-DO201-15; DO201-15
JP8: PINHD-1X4; 1X04
PWR_5V, PWR_10V, PWR_12V: RED; CHIPLED_1206
R1: 68k; R1206
R2: 10k; R1206
R4: 68; R1206
R5: 220; R1206
R6: 300; R1206
SW1, SW2: 1101M2S3CQE2
VR2: +5; TO-263-3L
VR3: LM1084-ADJ; TO-263-3L

Connections:
10V_FB: R1.1, R2.2, VR3.P$1 (ADJ)
12V_CON: CON_BATTERY.1, CON_BATTERY.2, SW1.2
12V_IN: D4.A, SW1.1 (O)
+5V: C3.1, D2.P$2, JP8.3, PWR_5V.A, VR2.P$2 (VO), VR2.P$4 (VO), VR2.P$5 (VO); also elsewhere on the board
+10V: C5.1, D3.P$2, JP8.2, PWR_10V.A, R1.2, VR3.P$2 (VO), VR3.P$4 (VO), VR3.P$5 (VO); also elsewhere on the board
+12V: C4.1, C6.1, CON_12V.1, CON_12V.2, CON_ROUTER.1, CON_ROUTER.2, D2.P$1, D3.P$1, D4.C, PWR_12V.A, SW2.2, VR2.P$3 (VIN), VR3.P$3 (VIN); also elsewhere on the board
GND: C3.2, C4.2, C5.2, C6.2, CON_12V.3, CON_12V.4, CON_BATTERY.3, CON_BATTERY.4, CON_FAN.3, CON_FAN.4, CON_ROUTER.3, CON_ROUTER.4, JP8.4, R2.1, R4.1, R5.1, R6.1, VR2.P$1 (GND); also elsewhere on the board
unnamed: PWR_5V.C, R4.2
unnamed: PWR_10V.C, R5.2
unnamed: PWR_12V.C, R6.2
unnamed: CON_FAN.1, CON_FAN.2, SW2.1 (O)

Notes on the sheet:
Vo = 1.25V * (1 + R1/R2)
1206 LEDs typically take 2.5V forward at 30mA
Voltage Regulation

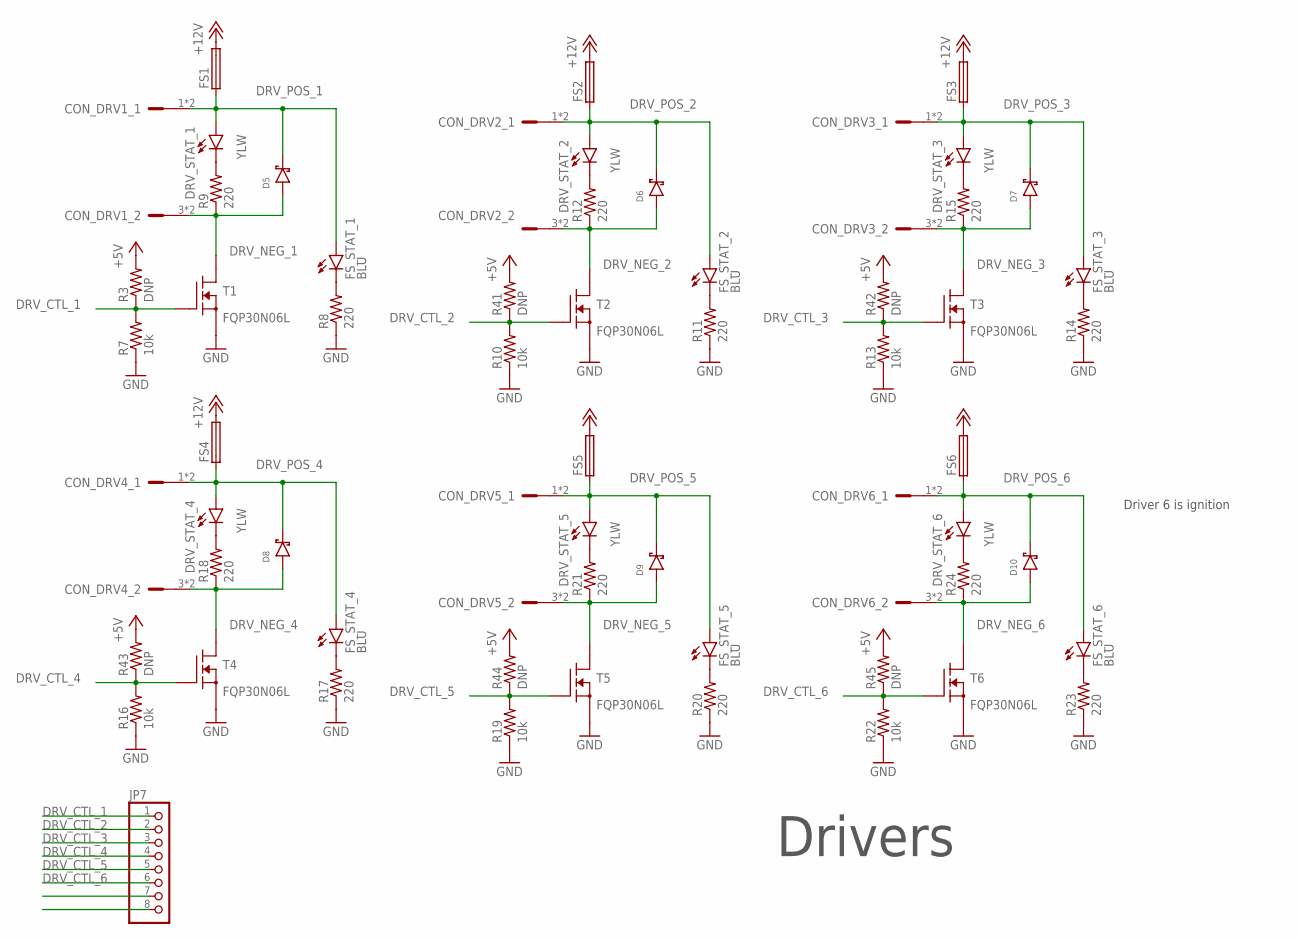
[picture p25: schematic arca-2.0.sch, sheet 2, Drivers]

Parts:
CON_DRV1, CON_DRV2, CON_DRV3, CON_DRV4, CON_DRV5, CON_DRV6: LPTA-2POS; 8.2X2
D5, D6, D7, D8, D9, D10: SS54; SS*
DRV_STAT_1, DRV_STAT_2, DRV_STAT_3, DRV_STAT_4, DRV_STAT_5, DRV_STAT_6: YLW; CHIPLED_1206
FS1, FS2, FS3, FS4, FS5, FS6: HOLDER_3588-20; 3588-20
FS_STAT_1, FS_STAT_2, FS_STAT_3, FS_STAT_4, FS_STAT_5, FS_STAT_6: BLU; CHIPLED_1206
JP7: PINHD-1X8; 1X08
R3, R41, R42, R43, R44, R45: DNP; R1206
R7, R10, R13, R16, R19, R22: 10k; R1206
R8, R9, R11, R12, R14, R15, R17, R18, R20, R21, R23, R24: 220; R1206
T1, T2, T3, T4, T5, T6: FQP30N06L; TO220V

Connections:
+5V: R3.2, R41.2, R42.2, R43.2, R44.2, R45.2; also elsewhere on the board
+12V: FS1.P$3 (2), FS1.P$4 (2), FS2.P$3 (2), FS2.P$4 (2), FS3.P$3 (2), FS3.P$4 (2), FS4.P$3 (2), FS4.P$4 (2), FS5.P$3 (2), FS5.P$4 (2), FS6.P$3 (2), FS6.P$4 (2); also elsewhere on the board
DRV_CTL_1: JP7.1, R3.1, R7.2, T1.1 (G); also elsewhere on the board
DRV_CTL_2: JP7.2, R10.2, R41.1, T2.1 (G); also elsewhere on the board
DRV_CTL_3: JP7.3, R13.2, R42.1, T3.1 (G); also elsewhere on the board
DRV_CTL_4: JP7.4, R16.2, R43.1, T4.1 (G); also elsewhere on the board
DRV_CTL_5: JP7.5, R19.2, R44.1, T5.1 (G); also elsewhere on the board
DRV_CTL_6: JP7.6, R22.2, R45.1, T6.1 (G); also elsewhere on the board
DRV_NEG_1: CON_DRV1.3, CON_DRV1.4, D5.P$2, R9.1, T1.2 (D)
DRV_NEG_2: CON_DRV2.3, CON_DRV2.4, D6.P$2, R12.1, T2.2 (D)
DRV_NEG_3: CON_DRV3.3, CON_DRV3.4, D7.P$2, R15.1, T3.2 (D)
DRV_NEG_4: CON_DRV4.3, CON_DRV4.4, D8.P$2, R18.1, T4.2 (D)
DRV_NEG_5: CON_DRV5.3, CON_DRV5.4, D9.P$2, R21.1, T5.2 (D)
DRV_NEG_6: CON_DRV6.3, CON_DRV6.4, D10.P$2, R24.1, T6.2 (D)
DRV_POS_1: CON_DRV1.1, CON_DRV1.2, D5.P$1, DRV_STAT_1.A, FS1.P$1 (1), FS1.P$2 (1), FS_STAT_1.A
DRV_POS_2: CON_DRV2.1, CON_DRV2.2, D6.P$1, DRV_STAT_2.A, FS2.P$1 (1), FS2.P$2 (1), FS_STAT_2.A
DRV_POS_3: CON_DRV3.1, CON_DRV3.2, D7.P$1, DRV_STAT_3.A, FS3.P$1 (1), FS3.P$2 (1), FS_STAT_3.A
DRV_POS_4: CON_DRV4.1, CON_DRV4.2, D8.P$1, DRV_STAT_4.A, FS4.P$1 (1), FS4.P$2 (1), FS_STAT_4.A
DRV_POS_5: CON_DRV5.1, CON_DRV5.2, D9.P$1, DRV_STAT_5.A, FS5.P$1 (1), FS5.P$2 (1), FS_STAT_5.A
DRV_POS_6: CON_DRV6.1, CON_DRV6.2, D10.P$1, DRV_STAT_6.A, FS6.P$1 (1), FS6.P$2 (1), FS_STAT_6.A
GND: R7.1, R8.1, R10.1, R11.1, R13.1, R14.1, R16.1, R17.1, R19.1, R20.1, R22.1, R23.1, T1.3 (S), T2.3 (S), T3.3 (S), T4.3 (S), T5.3 (S), T6.3 (S); also elsewhere on the board
unnamed: FS_STAT_2.C, R11.2
unnamed: DRV_STAT_2.C, R12.2
unnamed: FS_STAT_3.C, R14.2
unnamed: FS_STAT_1.C, R8.2
unnamed: DRV_STAT_1.C, R9.2
unnamed: DRV_STAT_3.C, R15.2
unnamed: FS_STAT_4.C, R17.2
unnamed: DRV_STAT_4.C, R18.2
unnamed: FS_STAT_5.C, R20.2
unnamed: DRV_STAT_5.C, R21.2
unnamed: FS_STAT_6.C, R23.2
unnamed: DRV_STAT_6.C, R24.2

Notes on the sheet:
Driver 6 is ignition
Drivers

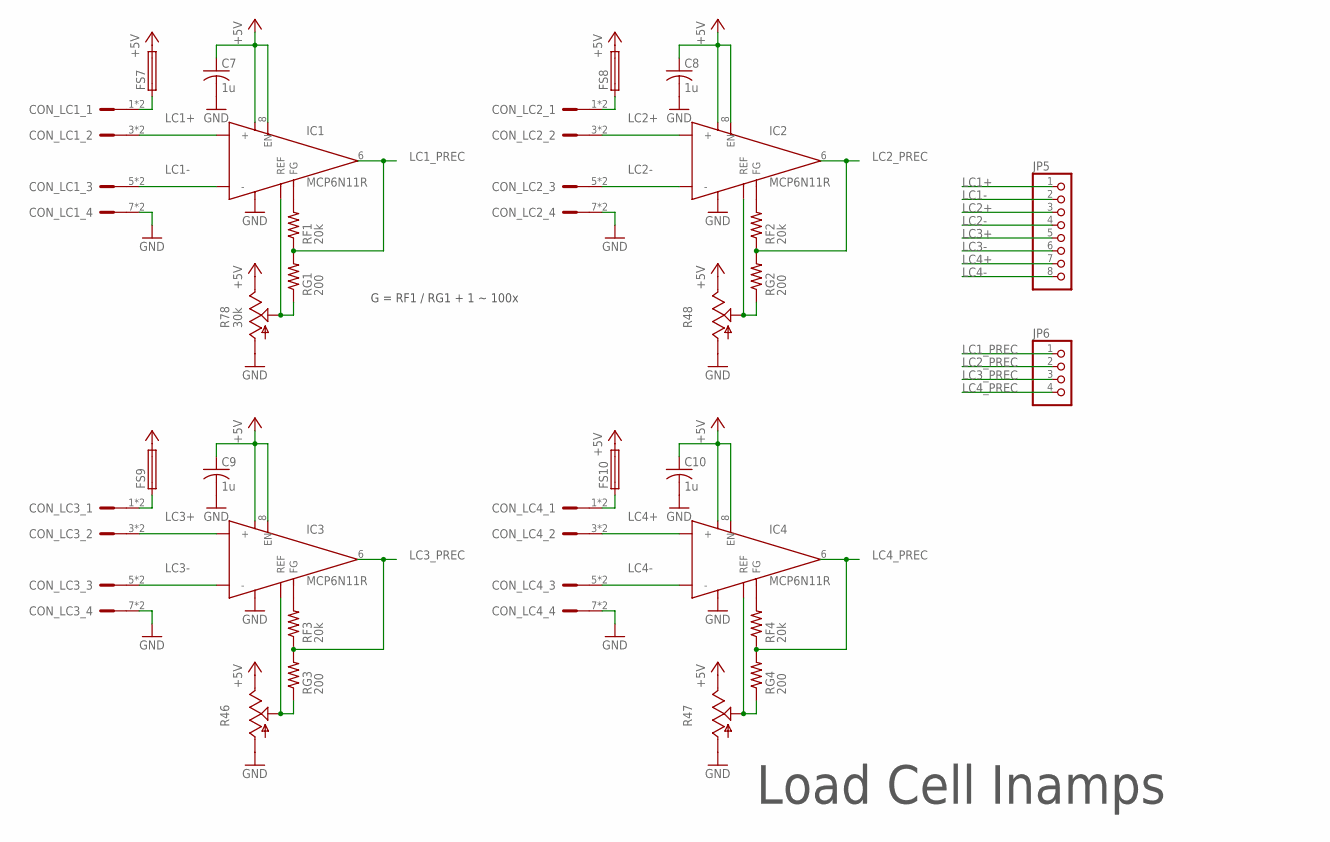
[picture p26: schematic arca-2.0.sch, sheet 3, Load Cell Inamps]

Parts:
C7, C8, C9, C10: 1u; C1206
CON_LC1, CON_LC2, CON_LC3, CON_LC4: LPTA-4POS; 8.2X4
FS7, FS8, FS9, FS10: HOLDER_3588-20; 3588-20
IC1, IC2, IC3, IC4: MCP6N11R; SO-8
JP5: PINHD-1X8; 1X08
JP6: PINHD-1X4; 1X04
R46, R47, R48: TRIM_US-S64W; S64W
R78: 30k; S64W
RF1, RF2, RF3, RF4: 20k; R1206
RG1, RG2, RG3, RG4: 200; R1206

Connections:
+5V: C7.1, C8.1, C9.1, C10.1, FS7.P$3 (2), FS7.P$4 (2), FS8.P$3 (2), FS8.P$4 (2), FS9.P$3 (2), FS9.P$4 (2), FS10.P$3 (2), FS10.P$4 (2), IC1.7 (+V), IC1.8 (EN), IC2.7 (+V), IC2.8 (EN), IC3.7 (+V), IC3.8 (EN), IC4.7 (+V), IC4.8 (EN), R46.E, R47.E, R48.E, R78.E; also elsewhere on the board
GND: C7.2, C8.2, C9.2, C10.2, CON_LC1.7, CON_LC1.8, CON_LC2.7, CON_LC2.8, CON_LC3.7, CON_LC3.8, CON_LC4.7, CON_LC4.8, IC1.4 (-V), IC2.4 (-V), IC3.4 (-V), IC4.4 (-V), R46.A, R47.A, R48.A, R78.A; also elsewhere on the board
LC1+: CON_LC1.3, CON_LC1.4, IC1.3 (+), JP5.1
LC1-: CON_LC1.5, CON_LC1.6, IC1.2 (-), JP5.2
LC1_PREC: IC1.6 (OUT), JP6.1, RF1.1, RG1.2; also elsewhere on the board
LC2+: CON_LC2.3, CON_LC2.4, IC2.3 (+), JP5.3
LC2-: CON_LC2.5, CON_LC2.6, IC2.2 (-), JP5.4
LC2_PREC: IC2.6 (OUT), JP6.2, RF2.1, RG2.2; also elsewhere on the board
LC3+: CON_LC3.3, CON_LC3.4, IC3.3 (+), JP5.5
LC3-: CON_LC3.5, CON_LC3.6, IC3.2 (-), JP5.6
LC3_PREC: IC3.6 (OUT), JP6.3, RF3.1, RG3.2; also elsewhere on the board
LC4+: CON_LC4.3, CON_LC4.4, IC4.3 (+), JP5.7
LC4-: CON_LC4.5, CON_LC4.6, IC4.2 (-), JP5.8
LC4_PREC: IC4.6 (OUT), JP6.4, RF4.1, RG4.2; also elsewhere on the board
unnamed: IC1.5 (REF), R78.S, RG1.1
unnamed: IC2.5 (REF), R48.S, RG2.1
unnamed: IC1.1 (FG), RF1.2
unnamed: IC2.1 (FG), RF2.2
unnamed: IC3.1 (FG), RF3.2
unnamed: IC4.1 (FG), RF4.2
unnamed: IC4.5 (REF), R47.S, RG4.1
unnamed: IC3.5 (REF), R46.S, RG3.1
unnamed: CON_LC1.1, CON_LC1.2, FS7.P$1 (1), FS7.P$2 (1)
unnamed: CON_LC2.1, CON_LC2.2, FS8.P$1 (1), FS8.P$2 (1)
unnamed: CON_LC3.1, CON_LC3.2, FS9.P$1 (1), FS9.P$2 (1)
unnamed: CON_LC4.1, CON_LC4.2, FS10.P$1 (1), FS10.P$2 (1)

Notes on the sheet:
Load Cell Inamps
G = RF1 / RG1 + 1 ~ 100x

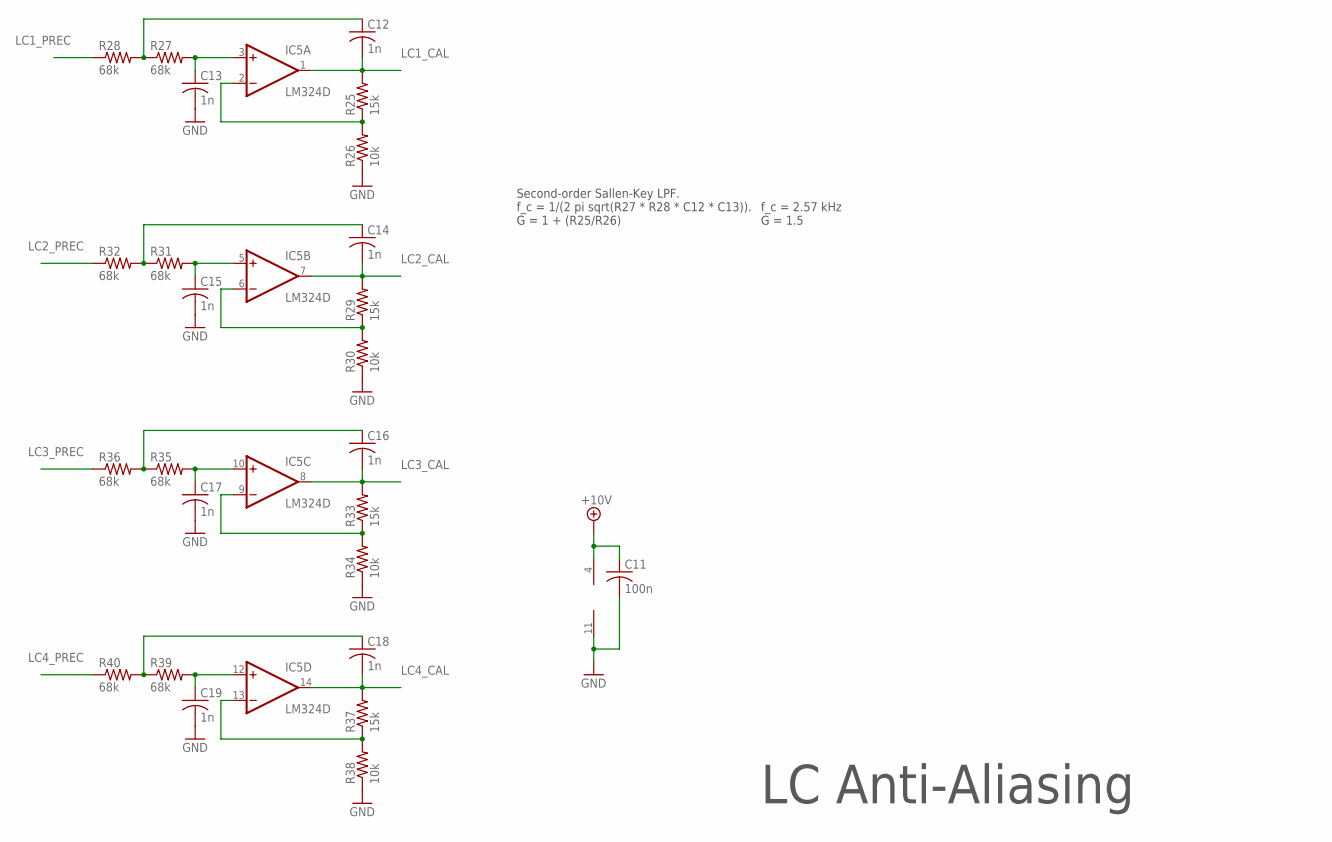
[picture p27: schematic arca-2.0.sch, sheet 4, Anti-Aliasing]

Parts:
C11: 100n; C1206
C12, C13, C14, C15, C16, C17, C18, C19: 1n; C1206
IC5: LM324D; SO14
R25, R29, R33, R37: 15k; R1206
R26, R30, R34, R38: 10k; R1206
R27, R28, R31, R32, R35, R36, R39, R40: 68k; R1206

Connections:
+10V: C11.1, IC5.4 (V+); also elsewhere on the board
GND: C11.2, C13.2, C15.2, C17.2, C19.2, IC5.11 (V-), R26.1, R30.1, R34.1, R38.1; also elsewhere on the board
LC1_CAL: C12.2, IC5.1 (OUT), R25.2; also elsewhere on the board
LC1_PREC: R28.1; also elsewhere on the board
LC2_CAL: C14.2, IC5.7 (OUT), R29.2; also elsewhere on the board
LC2_PREC: R32.1; also elsewhere on the board
LC3_CAL: C16.2, IC5.8 (OUT), R33.2; also elsewhere on the board
LC3_PREC: R36.1; also elsewhere on the board
LC4_CAL: C18.2, IC5.14 (OUT), R37.2; also elsewhere on the board
LC4_PREC: R40.1; also elsewhere on the board
unnamed: IC5.9 (-IN), R33.1, R34.2
unnamed: C17.1, IC5.10 (+IN), R35.2
unnamed: C16.1, R35.1, R36.2
unnamed: IC5.13 (-IN), R37.1, R38.2
unnamed: IC5.2 (-IN), R25.1, R26.2
unnamed: IC5.6 (-IN), R29.1, R30.2
unnamed: C13.1, IC5.3 (+IN), R27.2
unnamed: C12.1, R27.1, R28.2
unnamed: C15.1, IC5.5 (+IN), R31.2
unnamed: C14.1, R31.1, R32.2
unnamed: C19.1, IC5.12 (+IN), R39.2
unnamed: C18.1, R39.1, R40.2

Notes on the sheet:
Second-order Sallen-Key LPF. f_c = 1/(2 pi sqrt(R27 * R28 * C12 * C13)). G = 1 + (R25/R26)
f_c = 2.57 kHz G = 1.5
LC Anti-Aliasing

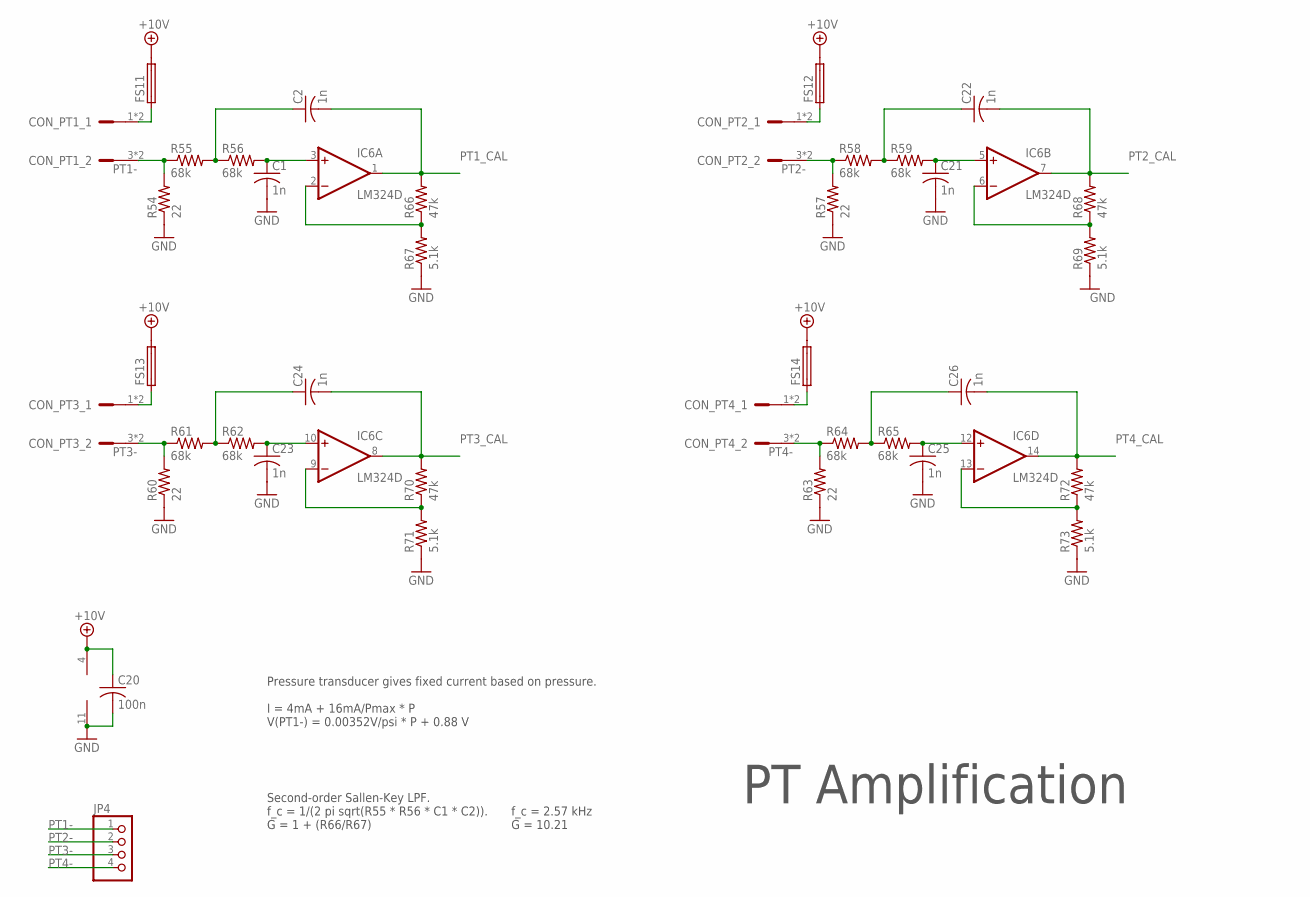
[picture p28: schematic arca-2.0.sch, sheet 5, Pressure Transducers]

Parts:
C1, C2, C21, C22, C23, C24, C25, C26: 1n; C1206
C20: 100n; C1206
CON_PT1, CON_PT2, CON_PT3, CON_PT4: LPTA-2POS; 8.2X2
FS11, FS12, FS13, FS14: HOLDER_3588-20; 3588-20
IC6: LM324D; SO14
JP4: PINHD-1X4; 1X04
R54, R57, R60, R63: 22; R1206
R55, R56, R58, R59, R61, R62, R64, R65: 68k; R1206
R66, R68, R70, R72: 47k; R1206
R67, R69, R71, R73: 5.1k; R1206

Connections:
+10V: C20.1, FS11.P$3 (2), FS11.P$4 (2), FS12.P$3 (2), FS12.P$4 (2), FS13.P$3 (2), FS13.P$4 (2), FS14.P$3 (2), FS14.P$4 (2), IC6.4 (V+); also elsewhere on the board
GND: C1.2, C20.2, C21.2, C23.2, C25.2, IC6.11 (V-), R54.1, R57.1, R60.1, R63.1, R67.1, R69.1, R71.1, R73.1; also elsewhere on the board
unnamed: C22.1, R58.2, R59.1
unnamed: C2.1, R55.2, R56.1
unnamed: C1.1, IC6.3 (+IN), R56.2
unnamed: C21.1, IC6.5 (+IN), R59.2
unnamed: C24.1, R61.2, R62.1
unnamed: C23.1, IC6.10 (+IN), R62.2
unnamed: C26.1, R64.2, R65.1
unnamed: C25.1, IC6.12 (+IN), R65.2
unnamed: IC6.13 (-IN), R72.1, R73.2
unnamed: IC6.9 (-IN), R70.1, R71.2
unnamed: IC6.6 (-IN), R68.1, R69.2
unnamed: IC6.2 (-IN), R66.1, R67.2
unnamed: CON_PT1.1, CON_PT1.2, FS11.P$1 (1), FS11.P$2 (1)
unnamed: CON_PT2.1, CON_PT2.2, FS12.P$1 (1), FS12.P$2 (1)
unnamed: CON_PT3.1, CON_PT3.2, FS13.P$1 (1), FS13.P$2 (1)
unnamed: CON_PT4.1, CON_PT4.2, FS14.P$1 (1), FS14.P$2 (1)
PT1-: CON_PT1.3, CON_PT1.4, JP4.1, R54.2, R55.1
PT1_CAL: C2.2, IC6.1 (OUT), R66.2; also elsewhere on the board
PT2-: CON_PT2.3, CON_PT2.4, JP4.2, R57.2, R58.1
PT2_CAL: C22.2, IC6.7 (OUT), R68.2; also elsewhere on the board
PT3-: CON_PT3.3, CON_PT3.4, JP4.3, R60.2, R61.1
PT3_CAL: C24.2, IC6.8 (OUT), R70.2; also elsewhere on the board
PT4-: CON_PT4.3, CON_PT4.4, JP4.4, R63.2, R64.1
PT4_CAL: C26.2, IC6.14 (OUT), R72.2; also elsewhere on the board

Notes on the sheet:
Pressure transducer gives fixed current based on pressure. I = 4mA + 16mA/Pmax * P V(PT1-) = 0.00352V/psi * P + 0.88 V
Second-order Sallen-Key LPF. f_c = 1/(2 pi sqrt(R55 * R56 * C1 * C2)). G = 1 + (R66/R67)
f_c = 2.57 kHz G = 10.21
PT Amplification

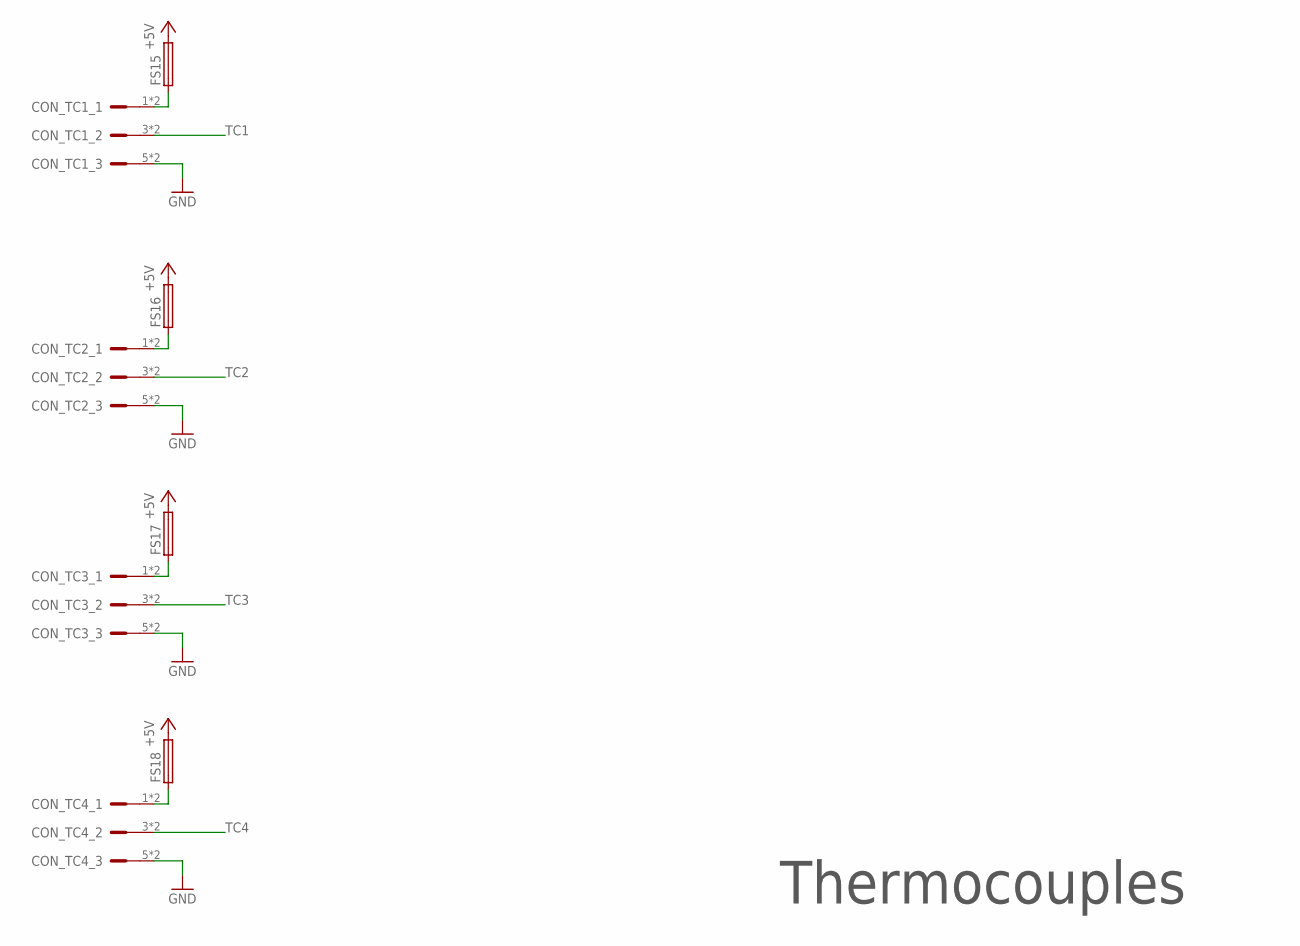
[picture p29: schematic arca-2.0.sch, sheet 6, Thermocouples]

Parts:
CON_TC1, CON_TC2, CON_TC3, CON_TC4: LPTA-3POS; 8.2X3
FS15, FS16, FS17, FS18: HOLDER_3588-20; 3588-20

Connections:
+5V: FS15.P$3 (2), FS15.P$4 (2), FS16.P$3 (2), FS16.P$4 (2), FS17.P$3 (2), FS17.P$4 (2), FS18.P$3 (2), FS18.P$4 (2); also elsewhere on the board
GND: CON_TC1.5, CON_TC1.6, CON_TC2.5, CON_TC2.6, CON_TC3.5, CON_TC3.6, CON_TC4.5, CON_TC4.6; also elsewhere on the board
unnamed: CON_TC1.1, CON_TC1.2, FS15.P$1 (1), FS15.P$2 (1)
unnamed: CON_TC2.1, CON_TC2.2, FS16.P$1 (1), FS16.P$2 (1)
unnamed: CON_TC3.1, CON_TC3.2, FS17.P$1 (1), FS17.P$2 (1)
unnamed: CON_TC4.1, CON_TC4.2, FS18.P$1 (1), FS18.P$2 (1)
TC1: CON_TC1.3, CON_TC1.4; also elsewhere on the board
TC2: CON_TC2.3, CON_TC2.4; also elsewhere on the board
TC3: CON_TC3.3, CON_TC3.4; also elsewhere on the board
TC4: CON_TC4.3, CON_TC4.4; also elsewhere on the board

Notes on the sheet:
Thermocouples

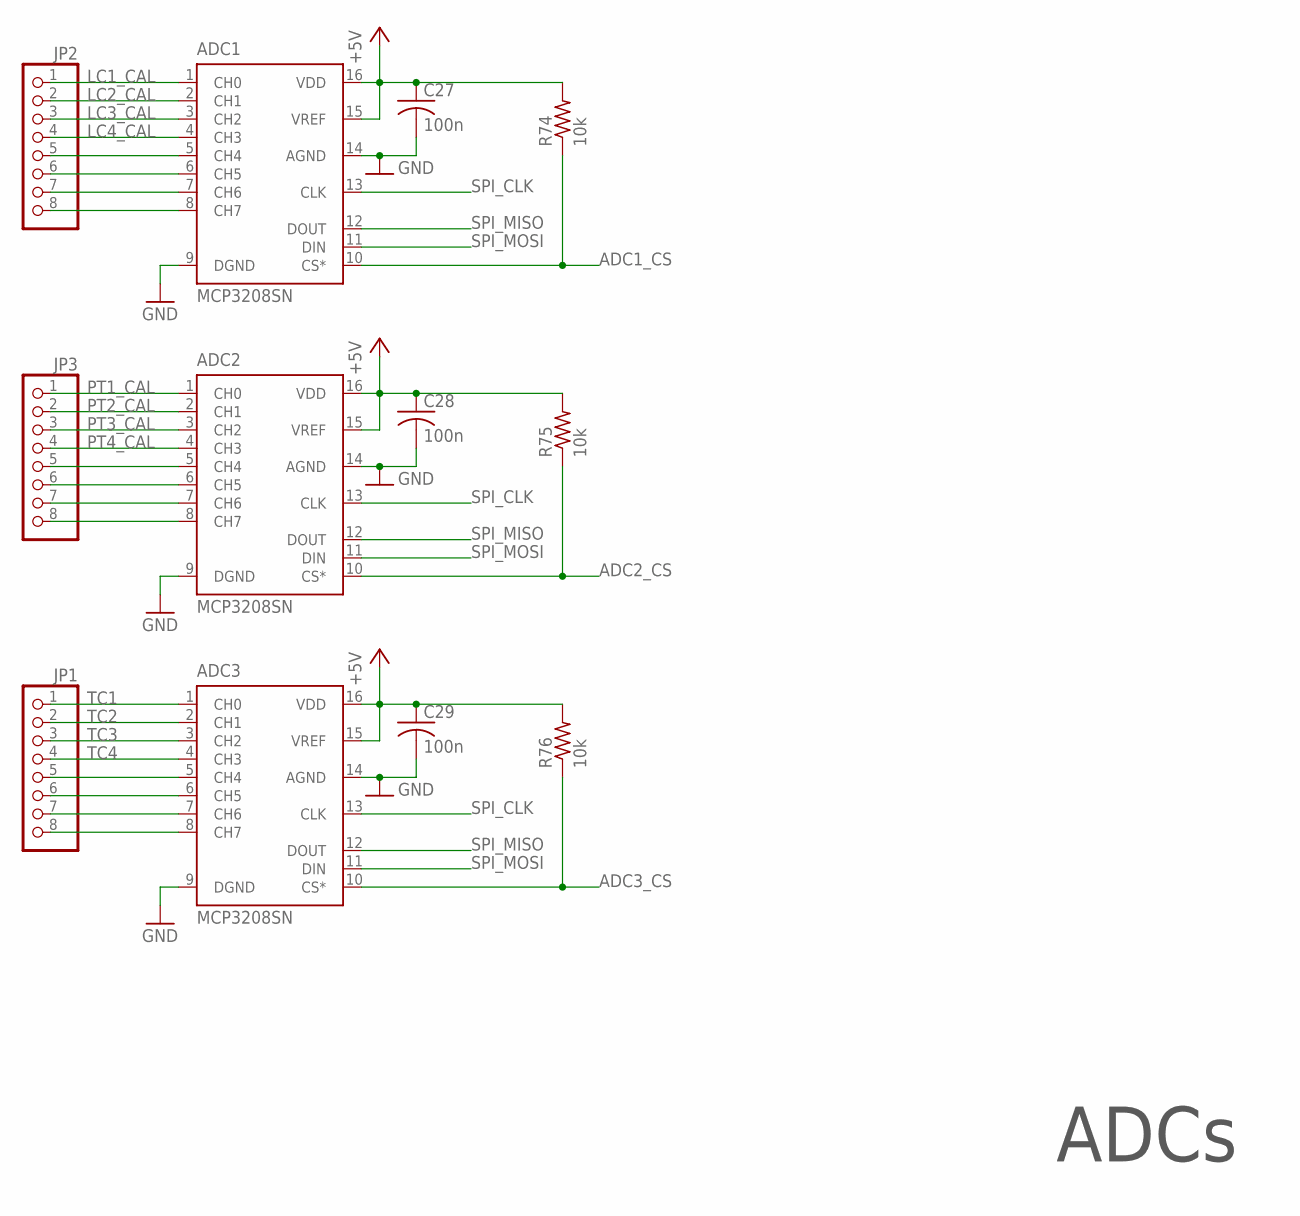
[picture p30: schematic arca-2.0.sch, sheet 7, ADC]

Parts:
ADC1, ADC2, ADC3: MCP3208SN; SO-16
C27, C28, C29: 100n; C1206
JP1, JP2, JP3: PINHD-1X8; 1X08
R74, R75, R76: 10k; R1206

Connections:
+5V: ADC1.15 (VREF), ADC1.16 (VDD), ADC2.15 (VREF), ADC2.16 (VDD), ADC3.15 (VREF), ADC3.16 (VDD), C27.1, C28.1, C29.1, R74.2, R75.2, R76.2; also elsewhere on the board
ADC1_CS: ADC1.10 (CS*), R74.1; also elsewhere on the board
ADC2_CS: ADC2.10 (CS*), R75.1; also elsewhere on the board
ADC3_CS: ADC3.10 (CS*), R76.1; also elsewhere on the board
GND: ADC1.9 (DGND), ADC1.14 (AGND), ADC2.9 (DGND), ADC2.14 (AGND), ADC3.9 (DGND), ADC3.14 (AGND), C27.2, C28.2, C29.2; also elsewhere on the board
LC1_CAL: ADC1.1 (CH0), JP2.1; also elsewhere on the board
LC2_CAL: ADC1.2 (CH1), JP2.2; also elsewhere on the board
LC3_CAL: ADC1.3 (CH2), JP2.3; also elsewhere on the board
LC4_CAL: ADC1.4 (CH3), JP2.4; also elsewhere on the board
unnamed: ADC3.5 (CH4), JP1.5
unnamed: ADC3.6 (CH5), JP1.6
unnamed: ADC3.7 (CH6), JP1.7
unnamed: ADC3.8 (CH7), JP1.8
unnamed: ADC1.8 (CH7), JP2.8
unnamed: ADC1.7 (CH6), JP2.7
unnamed: ADC1.6 (CH5), JP2.6
unnamed: ADC1.5 (CH4), JP2.5
unnamed: ADC2.5 (CH4), JP3.5
unnamed: ADC2.6 (CH5), JP3.6
unnamed: ADC2.7 (CH6), JP3.7
unnamed: ADC2.8 (CH7), JP3.8
PT1_CAL: ADC2.1 (CH0), JP3.1; also elsewhere on the board
PT2_CAL: ADC2.2 (CH1), JP3.2; also elsewhere on the board
PT3_CAL: ADC2.3 (CH2), JP3.3; also elsewhere on the board
PT4_CAL: ADC2.4 (CH3), JP3.4; also elsewhere on the board
SPI_CLK: ADC1.13 (CLK), ADC2.13 (CLK), ADC3.13 (CLK); also elsewhere on the board
SPI_MISO: ADC1.12 (DOUT), ADC2.12 (DOUT), ADC3.12 (DOUT); also elsewhere on the board
SPI_MOSI: ADC1.11 (DIN), ADC2.11 (DIN), ADC3.11 (DIN); also elsewhere on the board
TC1: ADC3.1 (CH0), JP1.1; also elsewhere on the board
TC2: ADC3.2 (CH1), JP1.2; also elsewhere on the board
TC3: ADC3.3 (CH2), JP1.3; also elsewhere on the board
TC4: ADC3.4 (CH3), JP1.4; also elsewhere on the board

Notes on the sheet:
ADCs

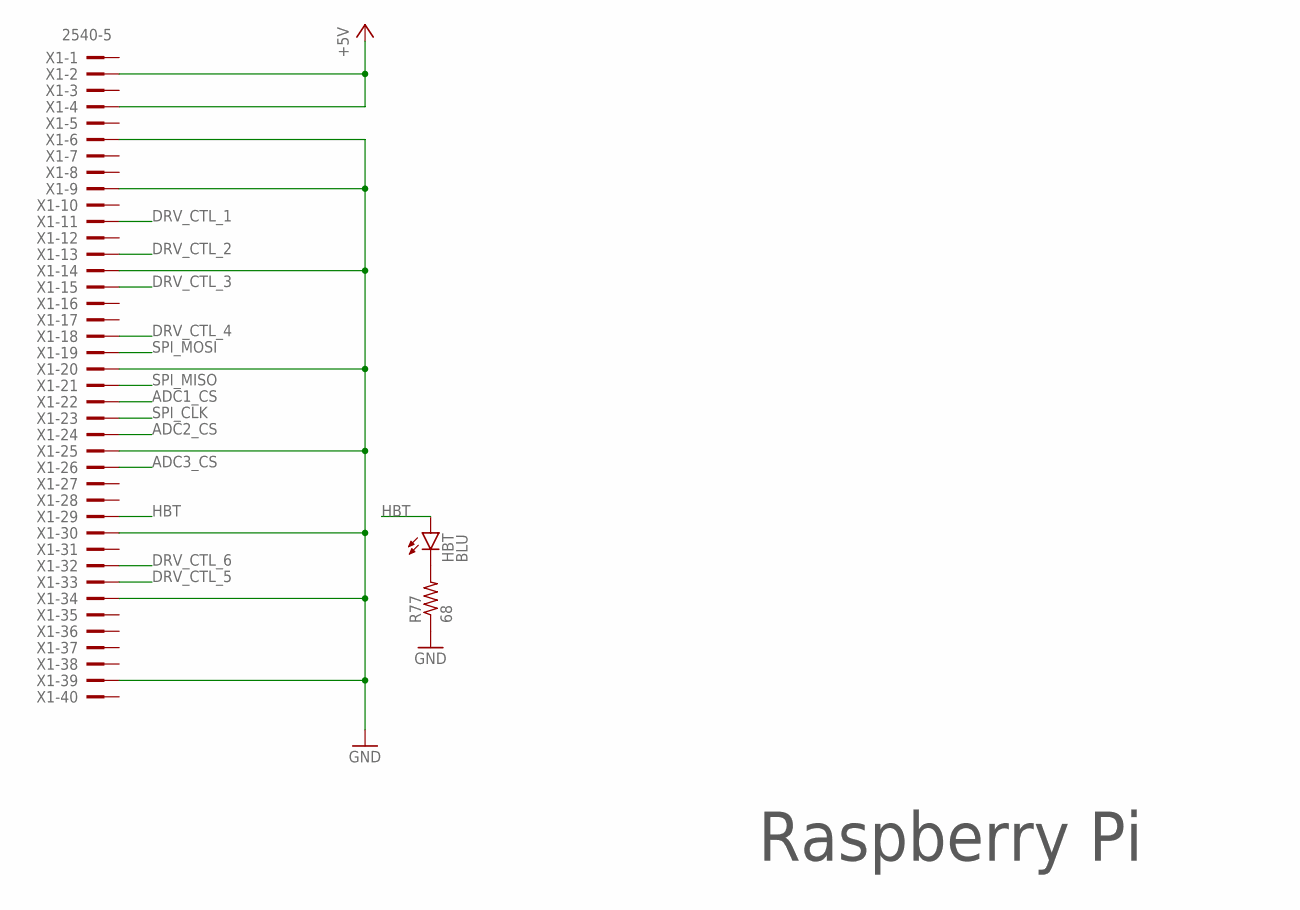
[picture p31: schematic arca-2.0.sch, sheet 8, Raspberry Pi]

Parts:
HBT: BLU; CHIPLED_1206
R77: 68; R1206
X1: 2540-5; PAK100/2500-5-40

Connections:
+5V: X1.2, X1.4; also elsewhere on the board
ADC1_CS: X1.22; also elsewhere on the board
ADC2_CS: X1.24; also elsewhere on the board
ADC3_CS: X1.26; also elsewhere on the board
DRV_CTL_1: X1.11; also elsewhere on the board
DRV_CTL_2: X1.13; also elsewhere on the board
DRV_CTL_3: X1.15; also elsewhere on the board
DRV_CTL_4: X1.18; also elsewhere on the board
DRV_CTL_5: X1.33; also elsewhere on the board
DRV_CTL_6: X1.32; also elsewhere on the board
GND: R77.1, X1.6, X1.9, X1.14, X1.20, X1.25, X1.30, X1.34, X1.39; also elsewhere on the board
HBT: HBT.A, X1.29
unnamed: HBT.C, R77.2
SPI_CLK: X1.23; also elsewhere on the board
SPI_MISO: X1.21; also elsewhere on the board
SPI_MOSI: X1.19; also elsewhere on the board

Notes on the sheet:
Raspberry Pi

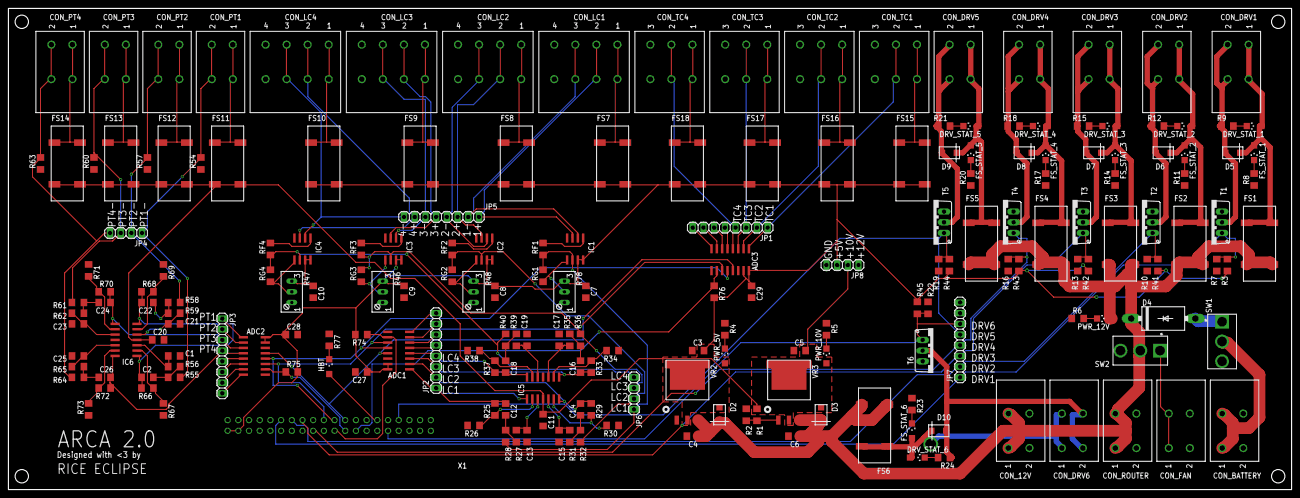
[picture p32: board arca-2.0.brd from above]

Board: 2 copper layers, 304.8 x 114.3 mm, 203 parts (1 on the bottom side), 133 nets.
