rice-eclipse/arca/ARCA/arca_PCAD_2021-04-03.PCB.brd

## EAGLE design ARCA/arca_PCAD_2021-04-03.PCB.brd (2021-04-04)

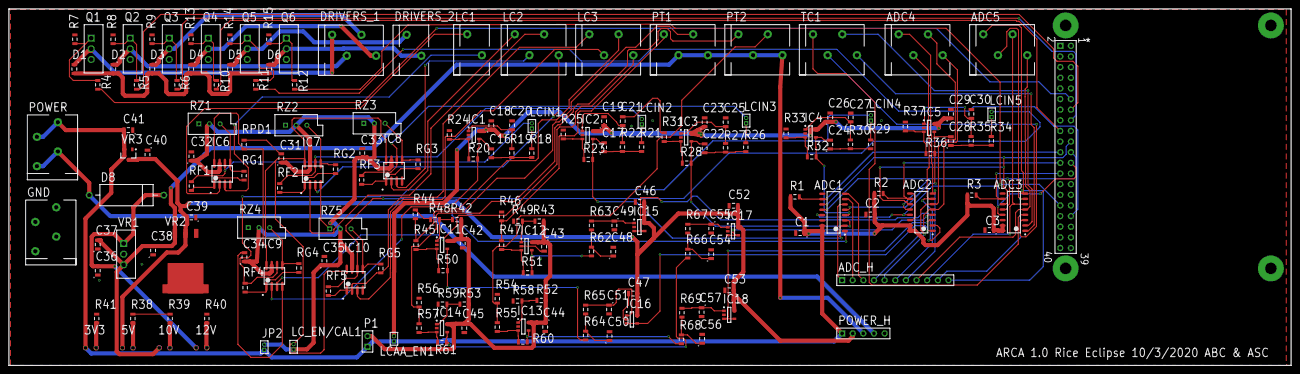
[picture p33: board arca_PCAD_2021-04-03.PCB.brd from above]

Board: 2 copper layers, 306.1 x 85.1 mm, 197 parts (0 on the bottom side), 114 nets.

Parts:
3V3: LED5MM; LED5MM_1PRIMARY
5V: LED5MM; LED5MM_4PRIMARY
10V: LED5MM; LED5MM_3PRIMARY
12V: LED5MM; LED5MM_2PRIMARY
*: raspberry_pi; HDR2X20_1PRIMARY
ADC1, ADC2, ADC3: MCP3208; SOIC127P600X175-16N_1PRIMARY
ADC4, ADC5: PTSA_1,5/_4-3,5-Z_-_1985218; 4PINCANCONNECTOR_1PRIMARY
ADC_H: Header_11; HDR1X11_1PRIMARY
C1, C2, C3, C39: Cap; CAPCP2012X06N_3PRIMARY
C16: 1nF; CAPCP2012X06N_16PRIMARY
C17, C21, C22, C24: 1nF; CAPCP2012X06N_14PRIMARY
C18: 0.1UF; CAPCP2012X06N_15PRIMARY
C19, C23, C26: 0.1UF; CAPCP2012X06N_14PRIMARY
C20: 1nF; CAPCP2012X06N_15PRIMARY
C25, C27: 1nF; CAPCP2012X06N_13PRIMARY
C28: 1nF; CAPCP2012X06N_11PRIMARY
C29: 0.1UF; CAPCP2012X06N_11PRIMARY
C30: 1nF; CAPCP2012X06N_12PRIMARY
C31: 1UF; CAPCP2012X06N_11PRIMARY
C32: 1UF; CAPCP2012X06N_2PRIMARY
C33: 1UF; CAPCP2012X06N_10PRIMARY
C34: 1UF; CAPCP2012X06N_9PRIMARY
C35: 1UF; CAPCP2012X06N_8PRIMARY
C36, C37, C38: Cap; CAPCP2012X06N_2PRIMARY
C40: Cap; CAPCP2012X06N_7PRIMARY
C41: Cap; CAPCP2012X06N_6PRIMARY
C42, C43, C44, C45: 0.1UF; CAPCP2012X06N_1PRIMARY
C46: 0.1UF; CAPCP2012X06N_5PRIMARY
C47, C52, C53: 0.1UF; CAPCP2012X06N_3PRIMARY
C48: 68nF; CAPCP2012X06N_4PRIMARY
C49, C51, C55, C57: 680pF; CAPCP2012X06N_1PRIMARY
C50, C54, C56: 68nF; CAPCP2012X06N_2PRIMARY
D1, D2, D3, D4, D5, D6: Diode; DIOC2012X06N_1PRIMARY
D8: Diode; DIODE-0.7_1PRIMARY
DRIVERS_1: 1991118; 4PINCANCONNECTOR_1PRIMARY
DRIVERS_2: 0; 2POS_GREEN_BOI_1PRIMARY
DUMMY1, DUMMY2, DUMMY3, DUMMY4: P:EX244Y244D1081
GND: 1991118; 4PINCANCONNECTOR_1PRIMARY
IC1, IC2, IC4: LMV321LICTRT; SOT95P245X110-5N_6PRIMARY
IC3: LMV321LICTRT; SOT95P245X110-5N_7PRIMARY
IC5: LMV321LICTRT; SOT95P245X110-5N_5PRIMARY
IC6, IC8, IC9, IC10: MCP6N11R; SOIC127P1030X265-8N_1PRIMARY
IC7: MCP6N11R; SOIC127P1030X265-8N_2PRIMARY
IC11: LMV321LICTRT; SOT95P245X110-5N_4PRIMARY
IC12, IC13, IC14, IC15, IC17: LMV321LICTRT; SOT95P245X110-5N_2PRIMARY
IC16: LMV321LICTRT; SOT95P245X110-5N_3PRIMARY
IC18: LMV321LICTRT; SOT95P245X110-5N_1PRIMARY
JP2: PINHD-1X2; MHDR1X2_4PRIMARY
LC1: 0; 2POS_GREEN_BOI_2PRIMARY
LC2: 1991118; 4PINCANCONNECTOR_6PRIMARY
LC3: 1991118; 4PINCANCONNECTOR_5PRIMARY
LCAA_EN1: PINHD-1X2; MHDR1X2_3PRIMARY
LCIN1: PINHD-1X2; MHDR1X2_4PRIMARY
LCIN2, LCIN3: PINHD-1X2; MHDR1X2_3PRIMARY
LCIN4: PINHD-1X2; MHDR1X2_2PRIMARY
LCIN5: PINHD-1X2; MHDR1X2_1PRIMARY
LC_EN/CAL1: PINHD-1X2; MHDR1X2_4PRIMARY
P1: Header_2; HDR1X2_1PRIMARY
POWER: 1991118; 4PINCANCONNECTOR_1PRIMARY
POWER_H: Header_5; HDR1X5_1PRIMARY
PT1: 1991118; 4PINCANCONNECTOR_4PRIMARY
PT2: 1991118; 4PINCANCONNECTOR_3PRIMARY
Q1, Q2, Q3, Q4, Q5, Q6: FQP30N06L-ND; UA78M_1PRIMARY
R1, R2, R3: Res1; RESC_0805_2012_6PRIMARY
R4, R5, R6, R10, R11, R12: Res1; RESC_0805_2012_8PRIMARY
R7: Res1; RESC_0805_2012_1PRIMARY
R8, R9, R13, R14, R15: Res1; RESC_0805_2012_17PRIMARY
R18: 24.7K; RESC_0805_2012_11PRIMARY
R19: 164K; RESC_0805_2012_16PRIMARY
R20: 50.6K; RESC_0805_2012_8PRIMARY
R21: 24.7K; RESC_0805_2012_15PRIMARY
R22: 164K; RESC_0805_2012_14PRIMARY
R23, R28, R32, R36: 50.6K; RESC_0805_2012_6PRIMARY
R24, R25, R37: 12.6K; RESC_0805_2012_2PRIMARY
R26: 24.7K; RESC_0805_2012_2PRIMARY
R27: 164K; RESC_0805_2012_1PRIMARY
R29: 24.7K; RESC_0805_2012_13PRIMARY
R30: 164K; RESC_0805_2012_12PRIMARY
R31, R33: 12.6K; RESC_0805_2012_11PRIMARY
R34: 24.7K; RESC_0805_2012_10PRIMARY
R35: 164K; RESC_0805_2012_9PRIMARY
R38: 140; RESC_0805_2012_2PRIMARY
R39: 470; RESC_0805_2012_1PRIMARY
R40: 530; RESC_0805_2012_1PRIMARY
R41: 39; RESC_0805_2012_2PRIMARY
R42, R43, R53: 20K; RESC_0805_2012_6PRIMARY
R44, R46, R56: 22; RESC_0805_2012_1PRIMARY
R45, R47, R55, R57: 20K; RESC_0805_2012_2PRIMARY
R48, R49, R58, R59: 3K; RESC_0805_2012_6PRIMARY
R50, R51, R60, R61: 150K; RESC_0805_2012_6PRIMARY
R52: 20K; RESC_0805_2012_8PRIMARY
R54: 22; RESC_0805_2012_7PRIMARY
R62, R64, R66, R68: 1.5K; RESC_0805_2012_1PRIMARY
R63, R65, R67, R69: 150K; RESC_0805_2012_1PRIMARY
RF1, RF3, RF4: 20K; RESC_0805_2012_1PRIMARY
RF2: 20K; RESC_0805_2012_4PRIMARY
RF5: 20K; RESC_0805_2012_5PRIMARY
RG1, RG3, RG4: 200; RESC_0805_2012_1PRIMARY
RG2: 200; RESC_0805_2012_4PRIMARY
RG5: 200; RESC_0805_2012_3PRIMARY
RPD1: 20K; RESC_0805_2012_2PRIMARY
RZ1, RZ3, RZ4: RPot; VR5_2PRIMARY
RZ2: RPot; VR5_3PRIMARY
RZ5: RPot; VR5_1PRIMARY
TC1: 1991118; 4PINCANCONNECTOR_2PRIMARY
VR1: UA78M; UA78M_1PRIMARY
VR2: LM1084ISX-5.0/NOPB; LM1084ISX-5.0/NOPB_1PRIMARY
VR3: AP2210N-3.3TRG1; SOT95P245X110-3N_1PRIMARY

Connections:
+3V3: 3V3.1, C1.1, JP2.1, LCAA_EN1.1, P1.1
+3V3_LC: C31.1, C32.1, C33.1, C34.1, C35.1, IC6.7, IC7.7, IC8.7, IC9.7, IC10.7, JP2.2, LC_EN/CAL1.1, RZ1.2, RZ2.2, RZ3.2, RZ4.2, RZ5.2
+3V3_LCAA: C18.1, C19.1, C23.1, C26.1, C29.1, IC1.5, IC2.5, IC3.5, IC4.5, IC5.5, LCAA_EN1.2
+3V3_PT: C42.1, C43.1, C44.1, C45.1, IC11.5, IC12.5, IC13.5, IC14.5, P1.2, R42.1, R43.1, R52.1, R53.1
+5V: 5V.1, C39.2, C40.2, C46.1, C47.1, C52.1, C53.1, IC15.5, IC16.5, IC17.5, IC18.5, POWER_H.2, VR2.2, VR3.3
+10V: 10V.1, C37.2, C38.2, POWER_H.3, VR1.3
+12: D1.2, D2.2, D3.2, D4.2, D5.2, D6.2
ADC1_A5: ADC1.6, ADC_H.1
ADC1_A6: ADC1.7, ADC_H.2
ADC1_A7: ADC1.8, ADC_H.3
ADC1_CS: *.22, ADC1.10, R1.1
ADC2_A4: ADC2.5, ADC_H.4
ADC2_A7: ADC2.8, ADC_H.7
ADC2_CS: *.24, ADC2.10, R2.1
ADC3_A4: ADC3.5, ADC_H.8
ADC3_CS: *.26, ADC3.10, R3.1
CAL: IC6.8, IC7.8, IC8.8, IC9.8, IC10.8, LC_EN/CAL1.2, RPD1.1
DRIVER_1: *.11, R4.1
DRIVER_1_NEGATIVE: D1.1, Q1.2
DRIVER_2: *.13, R5.1
DRIVER_2_NEGATIVE: D2.1, Q2.2
DRIVER_3: *.15, R6.1
DRIVER_3_NEGATIVE: D3.1, Q3.2
DRIVER_4: *.18, R10.1
DRIVER_4_NEGATIVE: D4.1, Q4.2
DRIVER_5: *.33, R11.1
DRIVER_5_NEGATIVE: D5.1, DRIVERS_2.1, Q5.2
DRIVER_6: *.32, R12.1
DRIVER_6_NEGATIVE: D6.1, DRIVERS_2.2, Q6.2
GND: C36.1, C38.1, GND.1, GND.2, GND.3, GND.4, R38.2, R39.1, R40.1, R41.2
LC1: ADC1.1, C16.2, IC1.4, R20.1
LC1_OUT_N: IC6.2, LC1.1
LC1_OUT_P: IC6.3, LC1.2
LC1_PREC: IC6.6, LCIN1.2, RF1.1
LC2: ADC1.2, C17.2, IC2.4, R23.1
LC2_PREC: IC7.6, LCIN2.2, RF2.1
LC3: ADC1.3, C22.2, IC3.4, R28.1
LC3_PREC: IC8.6, LCIN3.2, RF3.1
LC4: ADC1.4, C24.2, IC4.4, R32.1
LC4_PREC: IC9.6, LCIN4.2, RF4.1
LC5: ADC1.5, C28.2, IC5.4, R36.1
LC5_OUT_N: IC10.1, IC10.2, RF5.2, RG5.2
LC5_PREC: IC10.6, LCIN5.2, RF5.1
MISO: *.21, ADC1.12, ADC2.12, ADC3.12
MOSI: *.19, ADC1.11, ADC2.11, ADC3.11
NET3V3_K: 3V3.2, R41.1
NET5V_K: 5V.2, R38.1
NET10V_K: 10V.2, R39.2
NET12V_A: 12V.1, C36.2, D8.2, VR1.1
NET12V_K: 12V.2, R40.2
NETC16_1: C16.1, R18.1, R19.2
NETC17_1: C17.1, R21.1, R22.2
NETC20_1: C20.1, IC1.1, R19.1
NETC21_1: C21.1, IC2.1, R22.1
NETC22_1: C22.1, R26.1, R27.2
NETC24_1: C24.1, R29.1, R30.2
NETC25_1: C25.1, IC3.1, R27.1
NETC27_1: C27.1, IC4.1, R30.1
NETC28_1: C28.1, R34.1, R35.2
NETC30_1: C30.1, IC5.1, R35.1
NETC48_1: C48.1, R62.1, R63.2
NETC49_1: C49.1, IC15.1, R63.1
NETC50_1: C50.1, R64.1, R65.2
NETC51_1: C51.1, IC16.1, R65.1
NETC54_1: C54.1, R66.1, R67.2
NETC55_1: C55.1, IC17.1, R67.1
NETC56_1: C56.1, R68.1, R69.2
NETC57_1: C57.1, IC18.1, R69.1
NETIC1_3: IC1.3, R20.2, R24.1
NETIC2_3: IC2.3, R23.2, R25.1
NETIC3_3: IC3.3, R28.2, R31.1
NETIC4_3: IC4.3, R32.2, R33.1
NETIC5_3: IC5.3, R36.2, R37.1
NETIC6_1: IC6.1, RF1.2, RG1.2
NETIC6_5: IC6.5, RG1.1, RZ1.3
NETIC7_1: IC7.1, RF2.2, RG2.2
NETIC7_5: IC7.5, RG2.1, RZ2.3
NETIC8_1: IC8.1, RF3.2, RG3.2
NETIC8_5: IC8.5, RG3.1, RZ3.3
NETIC9_1: IC9.1, RF4.2, RG4.2
NETIC9_5: IC9.5, RG4.1, RZ4.3
NETIC10_5: IC10.5, RG5.1, RZ5.3
NETIC11_1: IC11.1, R42.2, R48.1
NETIC11_3: IC11.3, R45.1, R50.2
NETIC12_1: IC12.1, R43.2, R49.1
NETIC12_3: IC12.3, R47.1, R51.2
NETIC13_1: IC13.1, R52.2, R58.1
NETIC13_3: IC13.3, R55.1, R60.2
NETIC14_1: IC14.1, R53.2, R59.1
NETIC14_3: IC14.3, R57.1, R61.2
NETLCIN1_1: LCIN1.1, R18.2
NETLCIN2_1: LCIN2.1, R21.2
NETLCIN3_1: LCIN3.1, R26.2
NETLCIN4_1: LCIN4.1, R29.2
NETLCIN5_1: LCIN5.1, R34.2
NETQ1_1: Q1.1, R4.2, R7.2
NETQ2_1: Q2.1, R5.2, R8.2
NETQ3_1: Q3.1, R6.2, R9.2
NETQ4_1: Q4.1, R10.2, R13.2
NETQ5_1: Q5.1, R11.2, R14.2
NETQ6_1: Q6.1, R12.2, R15.2
PT1: ADC2.1, IC16.3, IC16.4
PT1_OUT: R44.2, R45.2
PT1_PREC: IC11.4, R50.1, R64.2
PT2: ADC2.2, IC15.3, IC15.4
PT2_OUT: R46.2, R47.2
PT2_PREC: IC12.4, R51.1, R62.2
PT3: ADC2.3, IC18.3, IC18.4
PT3_OUT: R54.2, R55.2
PT3_PREC: IC13.4, R60.1, R68.2
PT4: ADC2.4, IC17.3, IC17.4
PT4_OUT: R56.2, R57.2
PT4_PREC: IC14.4, R61.1, R66.2
SCK: *.23, ADC1.13, ADC2.13, ADC3.13
