rice-eclipse/arca/(commit log)

2020-01-03 hardware files
    [ADC_Breakout.SchDoc, ADC_SCH.SchDoc, ARCA_SCHLIB.SchLib, Heating_Tape.SchDoc, LC_to_ADC.SchDoc, Load_Cells_SCH.SchDoc, PI_SCH.SchDoc, PT_to_ADCs.SchDoc]
2020-01-18 dded missing files
    [ARCAPCBLIB.PcbLib, ARCA_BOX_SCH.SchDoc, ARCA_INNERBOX.SchDoc, Ignitors_SCH.SchDoc, Pressure_Transducers_SCH.SchDoc, Thermocouples_SCH.SchDoc, Top_Level_SCH.SchDoc, arca.PrjPCB]
2020-01-18 Attempt 2 at fixing things
    [RASPBERRY_PI_B_.PcbLib, RASPBERRY_PI_B_.SchLib, Valve_SCH.SchDoc]
2020-01-18 Fix PrjPCB attempt
    [arca.PrjPCB]
2020-01-18 adc sch
    [ADC_SCH.SchDoc, arca.PrjPCB]
2020-01-25 removed duplicate adc sch
    [SPI_SCH.SchDoc]
2020-01-25 adc_sch done
    [ADC_SCH.SchDoc]
2020-01-25 LC Sch done
    [Load_Cells_SCH.SchDoc]
2020-01-25 duplicate relay sch deleted
    [Relay_SCH.SchDoc, arca.PrjPCB]
2020-01-25 pt sch renames
    [Pressure_Transducers_SCH.SchDoc]
2020-01-25 duplicate test point sch deleted
    [ARCA_BOX_SCH.SchDoc, Load_Cells_SCH.SchDoc, Test_Points_SCH.SchDoc, arca.PrjPCB]
2020-01-25 ignitor mods
    [Ignitors_SCH.SchDoc, LC_to_ADC.SchDoc, Thermocouples_SCH.SchDoc, arca.PrjPCB]
2020-01-25 added connector page
    [ARCA_SCHLIB.SchLib, Connectors.SchDoc]
2020-01-26 added connectors and broke out adcs
    [ARCA_SCHLIB.SchLib, Connectors.SchDoc, LC_to_ADC.SchDoc, arca.PrjPCB]
2020-01-26 con done
    [Connectors.SchDoc, Heating_Tape.SchDoc, PI_SCH.SchDoc]
2020-01-26 grounded pi
    [PI_SCH.SchDoc]
2020-01-26 heating tape mock up
    [Heating_Tape.SchDoc]
2020-02-01 fourth solenoid circuit removed
    [PI_SCH.SchDoc, Solenoids_SCH.SchDoc]
2020-02-08 driver circuit added, old drivers Free
    [Miscellaneous Devices.PcbLib, Miscellaneous Devices.SchLib, Outputs_SCH.SchDoc, PI_SCH.SchDoc, Solenoids_SCH.SchDoc, arca.PrjPCB, drivers_SCH.SchDoc]
2020-02-08 sch done? :D
    [Connectors.SchDoc, arca.PrjPCB, drivers_SCH.SchDoc]
2020-02-08 top level removed
    [arca.PrjPCB]
2020-02-08 prelayout clean up
    [ADC_SCH.SchDoc, ARCAPCBLIB.PcbLib, IRF640.PcbLib, IRF640.SchLib, PI_SCH.SchDoc, Power.SchDoc, TO254P1054X470X1955-3.PcbLib, arca.PrjPCB]
2020-02-09 cleaned power sch
    [1101M2S3CQE2.PcbLib, 1101M2S3CQE2.SchLib, ARCAPCBLIB.PcbLib, Power.SchDoc, TO254P1435X464-4N.PcbLib, arca.PrjPCB]
2020-02-16 re annotated designators and addressed some erc errors
    [ADC_SCH.SchDoc, Connectors.SchDoc, Ignitors_SCH.SchDoc, LC_to_ADC.SchDoc, Load_Cells_SCH.SchDoc, PI_SCH.SchDoc, PT_to_ADCs.SchDoc, Power.SchDoc]
2020-03-07 ready for layout :)
    [ADC_SCH.SchDoc, ARCAPCBLIB.PcbLib, Connectors.SchDoc, LC_to_ADC.SchDoc, Load_Cells_SCH.SchDoc, PI_SCH.SchDoc, PT_to_ADCs.SchDoc, Power.SchDoc]
2020-03-07 okay, now its layout time; errors be gone
    [ADC_SCH.SchDoc, Connectors.SchDoc, LC_to_ADC.SchDoc, Load_Cells_SCH.SchDoc, PI_SCH.SchDoc, PT_to_ADCs.SchDoc, arca.PcbDoc, arca.PrjPCB]
2020-03-08 some layouts :D
    [ADC_SCH.SchDoc, ARCAPCBLIB.PcbLib, Connectors.SchDoc, Power.SchDoc, arca.PcbDoc, drivers_SCH.SchDoc]
2020-03-09 initial layout!
    [ADC_SCH.SchDoc, Connectors.SchDoc, LC_to_ADC.SchDoc, Load_Cells_SCH.SchDoc, PT_to_ADCs.SchDoc, Pressure_Transducers_SCH.SchDoc, arca.PcbDoc]
2020-04-11 pin inconsistency btwn sch and pcb fixed
    [Connectors.SchDoc, arca.PcbDoc, arca.PrjPCB]
2020-04-11 initial traces
    [arca.PcbDoc, arca.PrjPCB]
2020-04-18 Add more traces
    [arca.PcbDoc]
2020-04-18 Update ADC pin numbers in schlib
    [ARCA_SCHLIB.SchLib]
2020-04-18 Update ADC SCH with new pin numbers
    [ADC_SCH.SchDoc]
2020-04-18 Fix ADC pins in PCB
    [arca.PcbDoc]
2020-04-18 some ics routed
    [arca.PcbDoc]
2020-05-20 more traces added
    [arca.PcbDoc]
2020-05-20 added headers for power and extra adc channel breakout
    [Connectors.SchDoc, arca.PcbDoc]
2020-05-20 more traces for sensors
    [Load_Cells_SCH.SchDoc, arca.PcbDoc]
2020-05-20 failed attempts to fix adc
    [ADC_SCH.SchDoc, arca.PcbDoc]
2020-05-20 adcs given back footprint of sop64
    [ADC_SCH.SchDoc, arca.PcbDoc]
2020-05-27 link btwn adc and footprint fixed and some tracin
    [arca.PcbDoc]
2020-05-27 some adc traces routed
    [arca.PcbDoc]
2020-05-27 Add more adc to header traces
    [arca.PcbDoc]
2020-05-27 route ADC spi
    [arca.PcbDoc]
2020-05-27 Fix driver nets and route
    [Connectors.SchDoc, arca.PcbDoc, drivers_SCH.SchDoc]
2020-05-27 PrjPCB update
    [arca.PrjPCB]
2020-05-29 Add BOM document
2020-06-04 auto route finished traces?
    [arca.PcbDoc, arca.PrjPCB]
2020-06-04 poly pours added
    [arca.PcbDoc]
2020-06-04 Fix pour over GND traces
    [arca.PcbDoc, arca.PrjPCB]
2020-06-04 Design rules
    [arca.PcbDoc, arca.PrjPCB]
2020-06-11 acid trap reduction from auto route
    [arca.PcbDoc]
2020-06-12 exports added to prj
    [arca.PrjPCB]
2020-06-18 Add grounded mounting holes
    [arca.PcbDoc, arca.PrjPCB]
2020-06-25 breakout mounting holes
    [arca.PcbDoc]
2020-06-25 holes moved
    [arca.PcbDoc]
2020-06-25 jk now theyre moved
    [arca.PrjPCB]
2020-07-21 untangled raspberry pi connections
    [arca.PcbDoc]
2020-07-21 first draft
    [arca.PcbDoc]
2020-07-22 drc mods
    [arca.PcbDoc]
2020-09-12 this is probably the most right version
    [arca.PcbDoc]
2020-09-19 fixed raspberry pi issues, very few design rule check errors left!
    [ARCA_SCHLIB.SchLib, PI_SCH.SchDoc, arca.PcbDoc, arca.PrjPCB]
2020-09-25 -bad adcs but good drc
    [ADC_SCH.SchDoc, arca.DWG, arca.PcbDoc]
2020-09-25 new old adcs added, still need routing
    [ADC_SCH.SchDoc, ARCAPCBLIB.PcbLib, ARCA_SCHLIB.SchLib, arca.PcbDoc]
2020-10-03 new old adcs traced in
    [arca.PcbDoc]
2020-10-03 happier drc
    [arca.PcbDoc]
2020-10-03 happiest drc! order time!
    [arca.PcbDoc]
2020-10-03 hell yeah; order time
    [arca.PcbDoc]
2020-10-03 board outline added
    [arca.PcbDoc]
2020-10-03 board labeled
    [arca.PcbDoc]
2020-10-03 logo added to board
    [arca.PcbDoc]
2021-03-30 MORE AAAAAAA
    [Connectors.SchDoc, Power.SchDoc, arca.PcbDoc, arca.PrjPCB, drivers_SCH.SchDoc]
2021-03-30 BOM work
    [Pick Place for arca.csv, arca.PcbDoc, pnp_Raw.csv]
2021-03-30 updated names + included edited BOM
    [BOM (Edited 2021-03-30 for JLC).csv, PNP (Raw 2021-03-30 for JLC).csv]
2021-03-31 PNP created
    [PNP (Edited 2021-03-30).csv, PNP (Raw 2021-03-30 for JLC).csv, Pick Place for arca.csv, arca.PrjPCB]
2021-04-02 Fixed PCAD (still have not exported CAM)
    [drill_1_16.xln, gerber_job.gbrjob, silkscreen_top.gbr]
2021-10-30 starting arca 2.0 voltage regulators
    [arca-2.0.sch]
2021-10-30 rough vr layout
    [arca-2.0.brd, arca-2.0.sch]
2021-10-30 made diode-ss less ugly
    [arca-2.0.sch]
2021-11-04 started on LC work
    [arca-2.0.brd, arca-2.0.sch]
2021-11-04 fixed incorrect feedback on LC inamp
    [arca-2.0.brd, arca-2.0.sch]
2021-11-07 rip 3.3v
    [arca-2.0.brd, arca-2.0.sch]
2021-11-07 more compact drivers
    [arca-2.0.brd]
2021-11-12 concept for PTs
    [arca-2.0.brd, arca-2.0.sch]
2021-11-19 now with 10x gain on PTs
    [arca-2.0.brd, arca-2.0.sch]
2021-11-19 board relay concept
    [arca-2.0.brd]
2021-11-30 updating board with results from data analysis
    [arca-2.0.brd, arca-2.0.sch]
2021-11-30 ADCs now added
    [arca-2.0.brd, arca-2.0.sch]
2021-11-30 raspberry pi pinouts
    [arca-2.0.brd, arca-2.0.sch]
2021-11-30 some preliminary routing - ready for autorouter?
    [arca-2.0.brd]
2021-12-01 first rev of board
    [arca-2.0.brd, arca-2.0.sch]
2022-01-04 resistor cleanup for v_ref
    [arca-2.0.brd, arca-2.0.sch]
2022-01-04 throwing together some reference docs
    [battery-source-resistance-outline.sch]
2022-01-20 separate fuses for each external connection + LM324s on +10V
    [arca-2.0.brd, arca-2.0.sch]
2022-01-26 laying out extra breakers in board
    [arca-2.0.brd, arca-2.0.sch]
2022-02-05 heartbeat light
    [arca-2.0.brd, arca-2.0.sch]
2022-02-08 found issues with connector orientation
    [AC_LPT_2_5_LEVER.SLDPRT, CONNECTOR ANGLED 5MM PITCH (PHOENIX LPTA 2.5-X-5.0).SLDASM, DK_LPTA_2_5_5_00.SLDPRT, LP_LPT_2_5_3_50.SLDPRT, PK_LPTA_2_5_5_00.SLDPRT, arca-2.0.brd, arca-2.0.sch]
2022-02-08 solid model referencing has revealed incorrectly sized connectors
    [AC_LPT_2_5_LEVER.SLDPRT, BOARD ARCA2.0 EAGLE EXPORT.SLDASM, BOARD ASSEMBLY.SLDASM, CONNECTOR ANGLED 5MM PITCH (PHOENIX LPTA 2.5-X-5.0).SLDASM, DK_LPTA_2_5_5_00.SLDPRT, LP_LPT_2_5_3_50.SLDPRT, PK_LPTA_2_5_5_00.SLDPRT, arca-2.0.brd]
2022-02-12 bigger 5mm connectors
    [arca-2.0.brd, arca-2.0.sch]
2022-02-12 routing on shrunken board
    [CONNECTOR ANGLED 5MM PITCH (PHOENIX LPTA 2.5-X-5.0).SLDASM, arca-2.0.brd]
2022-02-19 final revisions on board before design review
    [AC_LPT_2_5_LEVER.SLDPRT, BASE BOARD.SLDPRT, BOARD ARCA2.0 EAGLE EXPORT.SLDASM, BOARD ASSEMBLY.SLDASM, BOARD INSERT ASSEMBLY.SLDASM, CONNECTOR ANGLED 5MM PITCH (PHOENIX LPTA 2.5-X-5.0).SLDASM, PK_LPTA_2_5_5_00.SLDPRT, SHCS STL #4-40 (MCMASTER).SLDPRT]
2022-02-25 values tweaks as we make a BOM
    [arca-2.0.brd, arca-2.0.sch]
2022-03-01 slight reshaping of schematic to make more human-readable
    [arca-2.0.brd, arca-2.0.sch]
2022-03-04 add connector for router
    [arca-2.0.brd, arca-2.0.sch]
2022-03-04 move to potentiometers for load cells
    [arca-2.0.brd, arca-2.0.sch]
2022-03-05 cheaper fuses
    [arca-2.0.brd, arca-2.0.sch]
2022-03-20 preparing CAM
    [arca-2.0-box.sch, arca-2.0.brd, arca-2.0.sch]
