rice-eclipse/arca/(notices)

Notices in the files:
parts and their libraries:
COPYRIGHT: Copyright (C) 2015 Accelerated Designs. All rights reserved
